RaphMTHN/Drone-Arduino/README.md

# Drone-Arduino

A personnal project about making a drone from scratch

## Description

*TODO*

## References

Don't forget to check Jeff Rowberg's awesome job on the MPU5060 I'm using in this project !
