RaphMTHN/Drone-Arduino/3 Implementation et Ajustement du Modele/1 Implementation du Systeme/3 Core/Drone_Core/README.md

# Arduino Drone Core

## Utilisation

Le code a été développé et testé sur une carte Arduino Uno.

Il est nécessaire de copier les fichiers .h et .cpp requis dans le même répertoire que le fichier .ino afin que le code puisse compiler.
