RaphMTHN/Drone-Arduino/Vidéos/liens_youtube.md

# Liens Vidéos Youtube

[Projet Drone Arduino - Maquette instable](https://www.youtube.com/watch?v=5RiZT9Iv7X4)

[Projet Drone Arduino - Maquette stable (perturbation)](https://www.youtube.com/watch?v=U1GrYymJwgQ)

[Projet Drone Arduino - Maquette stable (échelon)](https://www.youtube.com/watch?v=97mEfpeCfaE)
