RaphMTHN/Drone-Arduino/Rapport/Equations/Coefficients.docx

## Hélice

ρ=1,255 kg m^(-3)

D_(constr) =0,2375 m

e_(constr) =0,02 m

Cp_(ideal) =0,76

C_(pexp) =0,66

K_(h_(const)) =9,26 E^(-6) N(rad s^(-1) )^(-2)

D_(maquette) =0,15 m

e_(maquette) =0,02m

K_(h_(maquette)) =1,75 E^(-6) N(rad s^(-1) )^(-2)

## Moteur

K_m =954 rad s^(-1)

C_0 =40%

τ=0,01 s

## Linéarisation Hélice

K_(hlin) =1,34E^(-3) N(rad s^(-1) )^(-1)

R_(i0) =0,255 N

## Inertie

λ=0,194 kg m^(-1)

L=0,24 m

l= 0,22 m

m_(moteur) =0.080 kg

J= 9,53 E^(-3) kg m^2

## Modèle de connaissance

K=11,27

τ=0,01 s

## Adaptation du modèle

K^(*) =31.4

τ^(*) =0,0137

K_(ajust) =2,79

K_(u0) =0,514

K_(consigne) =0,191
