RaphMTHN/Drone-Arduino/2 Modele de Connaissance/1 Helice/Graphiques/Courbe b'.pdf

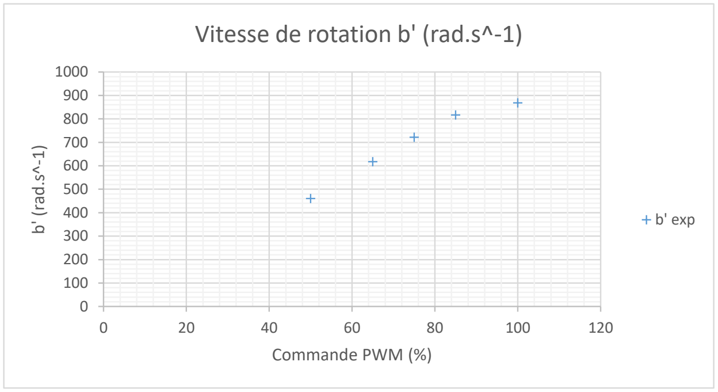
[picture p16: figure]
b' (rad.s^-1); Commande PWM (%); Vitesse de rotation b' (rad.s^-1); b' exp
