RaphMTHN/Drone-Arduino/5 Conclusion/conclusion.md

# Conclusion

## Analyse des résultats 

L’identification des paramètres du moteur et des hélices a permis de confirmer la validité des lois théoriques qui constituent le premier modèle.

L’ajustement de la modélisation corrige les imperfections causées par des hypothèses simplificatrices. Cependant, l’écart est assez important. Le modèle de connaissance n'est pas assez précis pour décrire le comportement réel du système.

Il faudra revoir la détermination des paramètres des différentes relations associées aux composants si l'on souhaite diminuer l'écart entre modèle de connaissance et modèle expérimental.

Le modèle ajusté a un comportement optimal pour des faibles corrections dérivatrices initiales.

Les réponses temporelles en suivi et en régulation de la maquette et de la modélisation se superposent très correctement.

Le système modélisé est plus rapide que le système réel. La maquette, cependant, présente des dépassements moins importants en réponse indicielle que la modélisation.

## Conclusion générale

Une fois les étapes d’analyse et d’élaboration d’un modèle théorique réalisées, c’est par la réalisation concrète et complète d’une maquette, et par l’ajustement de la modélisation au comportement du système réel que je suis parvenu à valider une première loi de commande, capable de s’adapter à des perturbations imprévisibles. S’il est impossible d’affirmer que la correction du système est optimale, la recherche de l’optimalité a été un fil conducteur au cours de mon travail.
