RaphMTHN/Drone-Arduino/Rapport/Equations/equation de dynamique.docx

J=2 ( (λL^3)/3+m_(moteur) l^2 )

λ :masse volumique du bras

L :longueur du bras

l :distance du moteur à l'axe

m_(moteur) :masse de l^(') ensemble moteur+hélice+variateur

On fait l’hypothèse que le système est parfaitement équilibré : le couple exercé par la pesanteur s’annule par symétrie.

On applique le théorème de la résultante dynamique au système en O projeté sur l’axe de roulis :

Jα=(R_3 -R_2 )l^2

α :angle de roulis
