RaphMTHN/Drone-Arduino/Rapport/Equations/fonction de transfert du système.docx

H_(BO) (p)=K/(p^2 (1+τp))

K=(2K_(consigne) K_m K_(h_(lin)) l^2)/J=26,14

τ=0,1 s

Le système est intrinsèquement instable : il faut nécessairement ajouter un correcteur dérivateur pour avoir une phase inférieure à π/2 . Ainsi, une fois un tel correcteur ajouté :

H_(BF) (p)=(K(K_p +K_d p))/(KK_p +KK_d p+p^2 +τp^3)

Le critère de Routh appliqué à la fonction de transfert du système corrigé par un dérivateur, de coefficient fixé K_d est :

K_p >0

K_p <(K_d)/τ

Le point critique est atteint lorsque le dénominateur de la fonction de transfert s’annule : l’étude fréquentielle du dénominateur fournit une équation respectée par la pulsation du système :

((KK_d)/τ-ω_u^2 )+jω_u τ((KK_d)/τ-ω_u^2 )=0

Ainsi les coordonnées du point critique sont, pour une valeur du gain du correcteur dérivateur K_d fixé :

K_u =K_d /τ

T_u =2π√(τ/(KK_d))

K_u =(K_d)/τ+K_(u0)
