RaphMTHN/Drone-Arduino/Rapport/Equations/traction de l'hélice.docx

En intégrant dFp_i sur toute l’hélice, d’incidence constante et symétrique par rapport à son axe de rotation, on obtient l’expression suivante :

La force de portance s’exerçant sur chaque petit élément de pale s’exprime :

dFp_i =1/2ρC_p Sv^2 z_i

Où :

ρ=1,255 kg m^(-3) :masse volumique de l'air

C_p :coefficient de portance de l'hélice

S=e dr :surface de l^(') élément de pale

e :épaisseur de l'hélice

β_i :vitesse de rotation de l'hélice

v=rβ_i :vitesse apparent de l'air

Ainsi :

R_i =Fp_i =1/24ρC_p eD^3 β_i ^2 z_i

Où :

D :diamètre de l'hélice
