RaphMTHN/Drone-Arduino/Rapport/Image Légende/image legende.docx

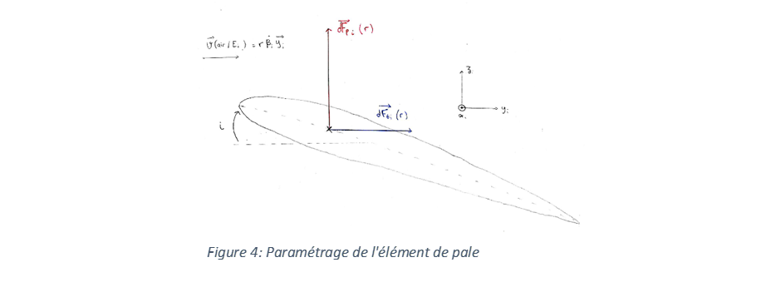
[picture p37: figure]
