RaphMTHN/Drone-Arduino/Rapport/Modalites Actions/Hélice.docx

# Hélice

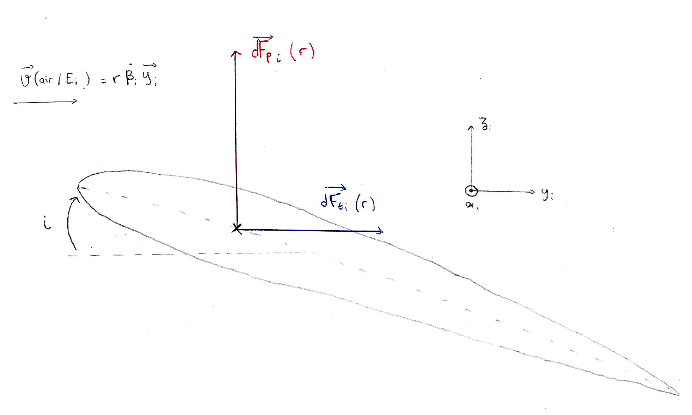
[picture p45: figure]

La force de portance s’exerçant sur chaque petit élément de pale s’exprime :

dFp_i =1/2ρC_p Sv^2 z_i

Où :

ρ=1,255 kg m^(-3) :masse volumique de l'air

C_p :coefficient de portance de l'hélice

S=e dr :surface de l^(') élément de pale

e :épaisseur de l'hélice

β_i :vitesse de rotation de l'hélice

v=rβ_i :vitesse apparent de l'air

Ainsi :

R_i =Fp_i =K_h β_i ^2 z_i

K_h =1/24ρC_p eD^3

Où :

D :diamètre de l'hélice

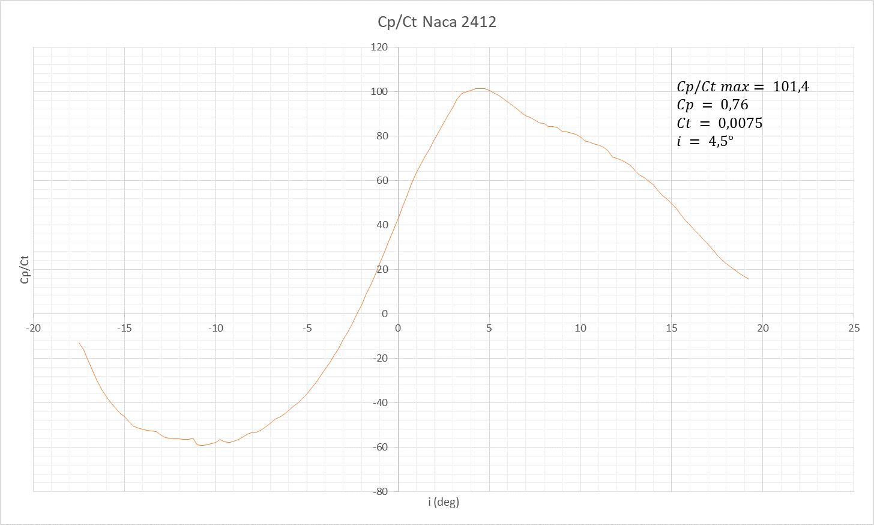
[picture p46: figure]
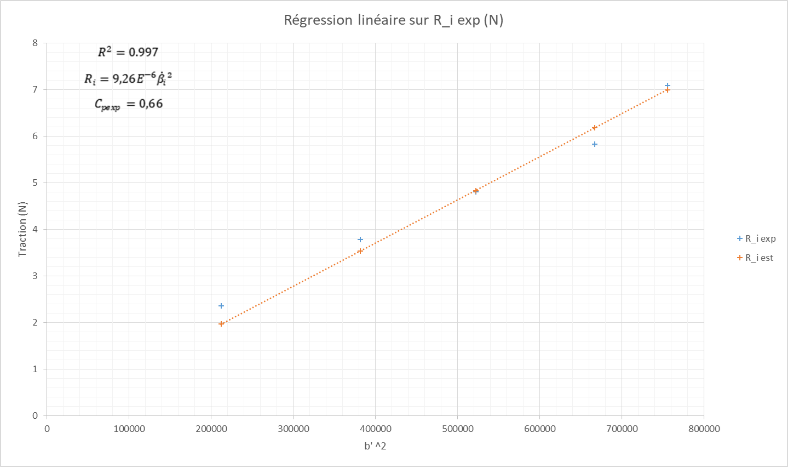
[picture p47: figure]

On identifie ainsi:

K_(h_(const)) =9,26 E^(-6) N(rad s^(-1) )^(-2)

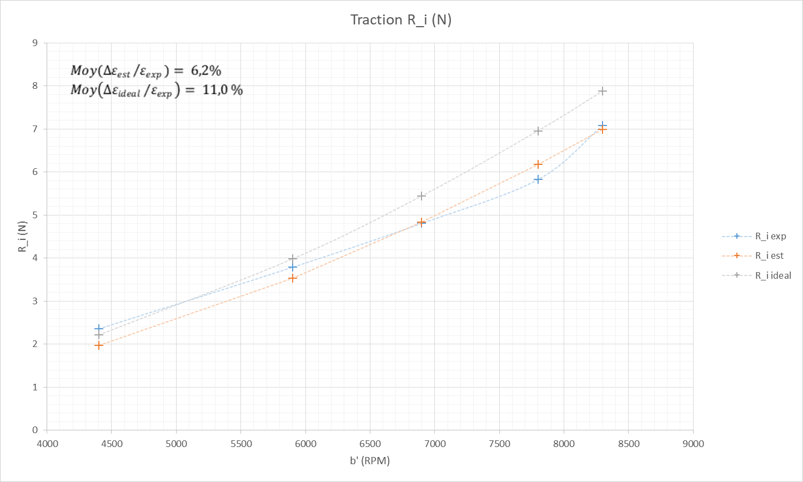
[picture p48: figure]

On adapte la valeur de K_(hmaquette) à l’aide des données géométriques des hélices installées sur la maquette, différentes de celles proposées par le constructeur :

D_(constr) =0,2375 m

e_(constr) =0,02 m

D_(maquette) =0,15 m

e_(maquette) =0,02m

D’où :

K_(h_(maquette)) =1,75 E^(-6) N(rad s^(-1) )^(-2)

On linéarise l’expression de la traction autour du point de fonctionnement de vol stationnaire :

R_i =K_(hlin) β_i +R_(i0)

K_(hlin) =2K_h β_(i0)

R_(i0) =K_h β_(i0)^2

On trouve, en choisissant le point de fonctionnement à 40% de la consigne maximale des moteurs :

C_0 =40%

K_(hlin) =1,34E^(-3) N(rad s^(-1) )^(-1)

R_(i0) =0,255 N

# Analyse des résultats

L’expression de la traction est confortée par le faible écart entre les résultats fournis par le constructeur du moteur et la régression linéaire. L’ordre de grandeur du coefficient de poussée adimensionné Cp est proche du Cp idéal pour un profil NACA (10% plus efficace en théorie).
