RaphMTHN/Drone-Arduino/2 Modele de Connaissance/2 Moteur/Reg Lin b' edited.docx

R²=0,9998

β=954 C_i

K_m =954 rad s^(-1)

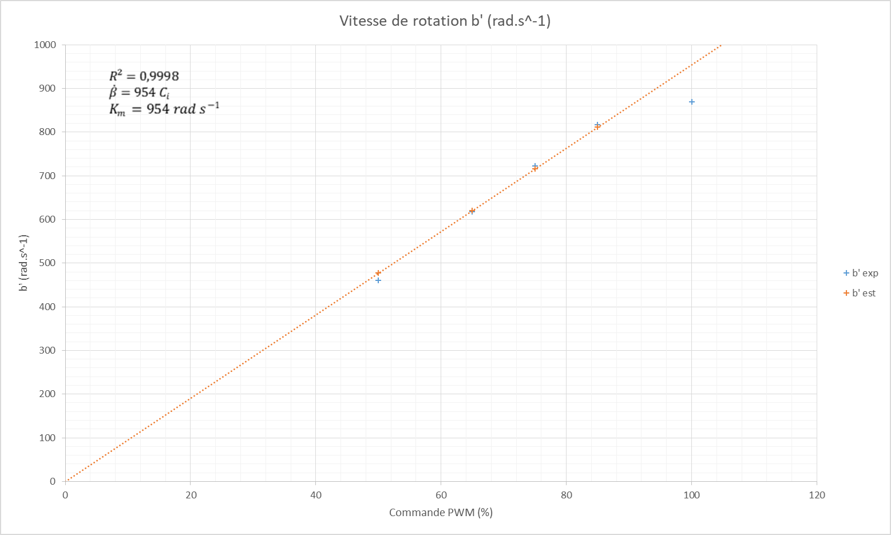
[picture p52: figure]
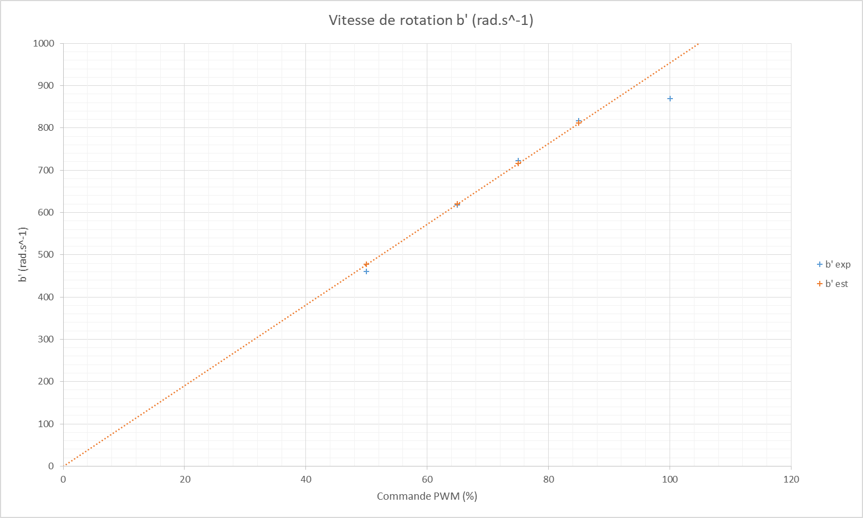
[picture p53: figure]
