RaphMTHN/Drone-Arduino/2 Modele de Connaissance/1 Helice/Graphiques retenus/1 Cp Naca 2412.docx

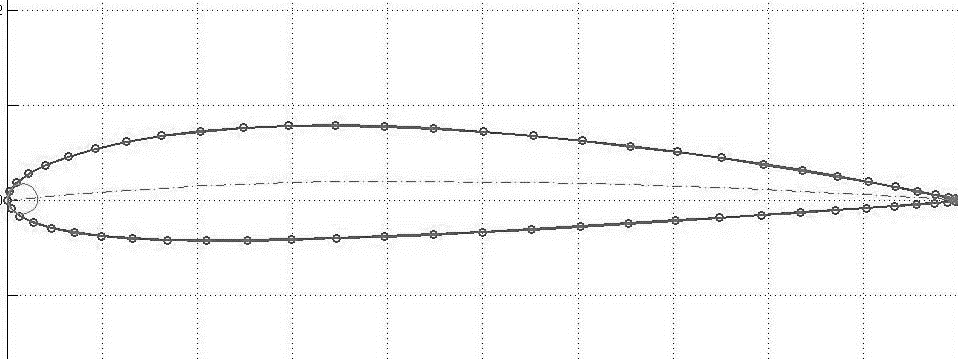
[picture p54: figure]
Résultat de recherche d'images pour "naca2412"
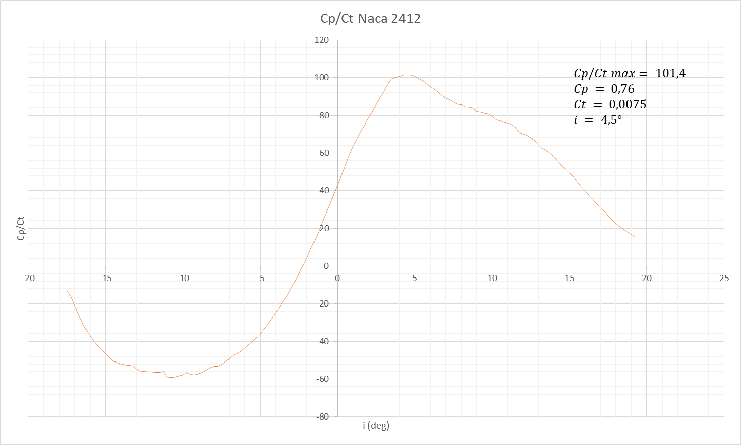
[picture p55: figure]
