RaphMTHN/Drone-Arduino/2 Modele de Connaissance/1 Helice/Graphiques retenus/2 Reg Lin R_i edited 2.docx

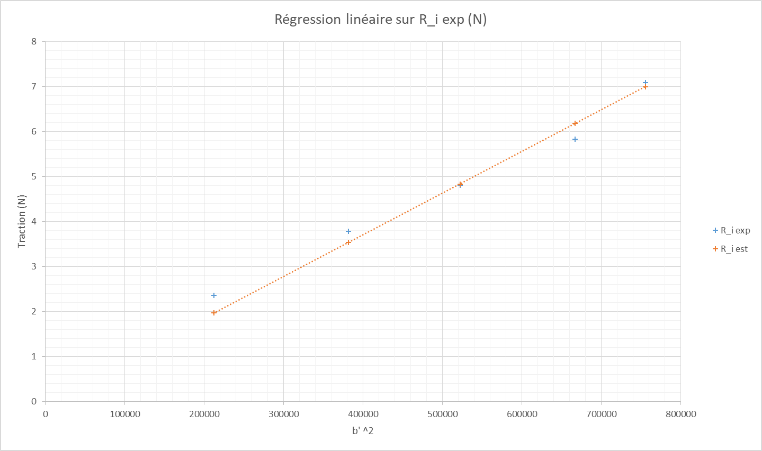
[picture p56: figure]
