RaphMTHN/Drone-Arduino/2 Modele de Connaissance/1 Helice/Graphiques retenus/2 Reg Lin R_i edited.docx

R^2 =0.997

R_i =9,26E^(-6) β_i ²

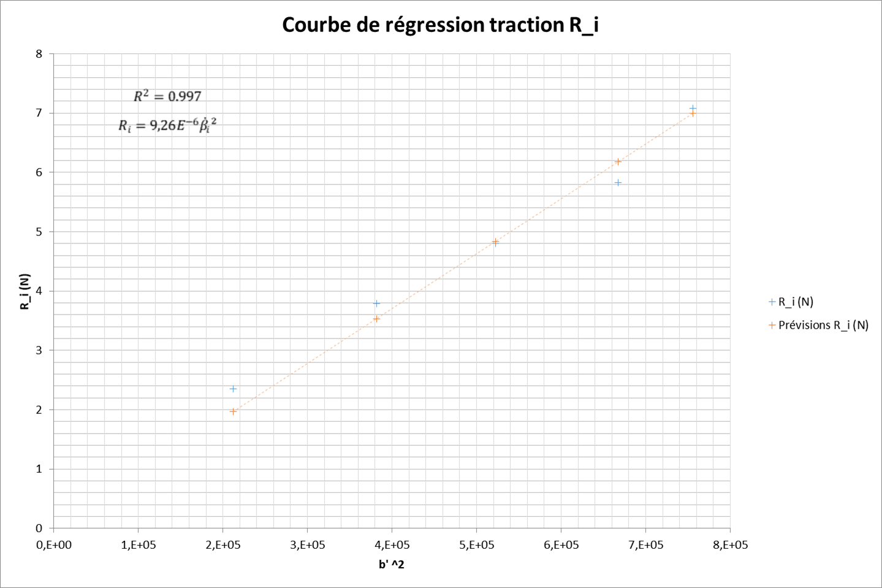
[picture p57: figure]
