RaphMTHN/Drone-Arduino/2 Modele de Connaissance/1 Helice/Graphiques retenus/3 Synthese modeles.docx

Moy((∆ε_(est))/(ε_(exp)))= 6,2%

Moy((∆ε_(ideal))/(ε_(exp)))= 11,0 %
