RaphMTHN/Drone-Arduino/2 Modele de Connaissance/1 Helice/Graphiques retenus/4 Linearisation Traction.docx

(∆ε_(lin))/(ε_(mod) <20% C_i ∈[28% ;72%])

C_(i0) = 40 %

K_(hlin) =7,07 E^(-3) N.(rad.s^(-1) )^(-1)

R_(i0) =1,348 N

K_(hlin) =2K_h β_0

R_(i0) =K_h β_0 ²
