RaphMTHN/Drone-Arduino/3 Implementation et Ajustement du Modele/2 Ajustement du Modele/Regressions Lineaires/Regression Ku adap.docx

R^2 =0,994

T_(uexp) =7,32*Kd+0,514

R^2 =0,994

T_(uexp) =7,32*Kd+0,514

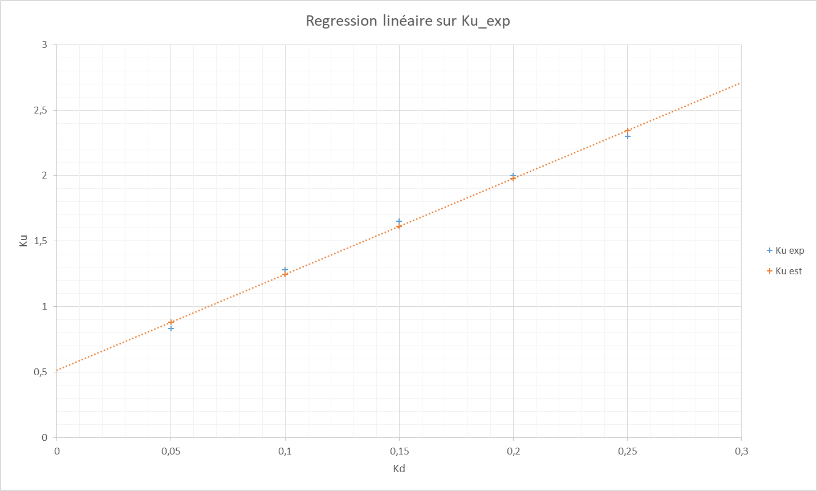
[picture p58: figure]
