RaphMTHN/Drone-Arduino/3 Implementation et Ajustement du Modele/2 Ajustement du Modele/Regressions Lineaires/Regression Tu adap.docx

R^2 =0,999

T_(uexp) =0,415√(1/(Kd))

R^2 =0,999

T_(uexp) =0,415√(1/(Kd))

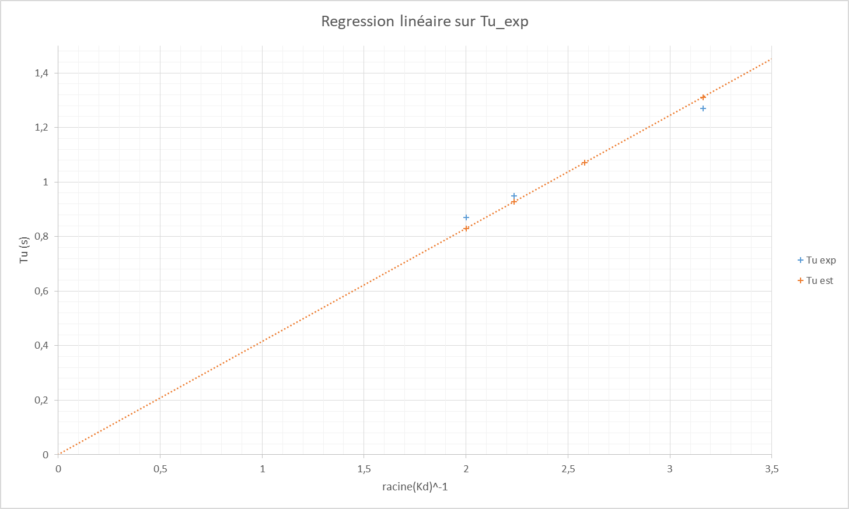
[picture p59: figure]
