RaphMTHN/Drone-Arduino/2 Modele de Connaissance/3 Dynamique/Inertie/pseudo_dessin_indus_maquette.pdf

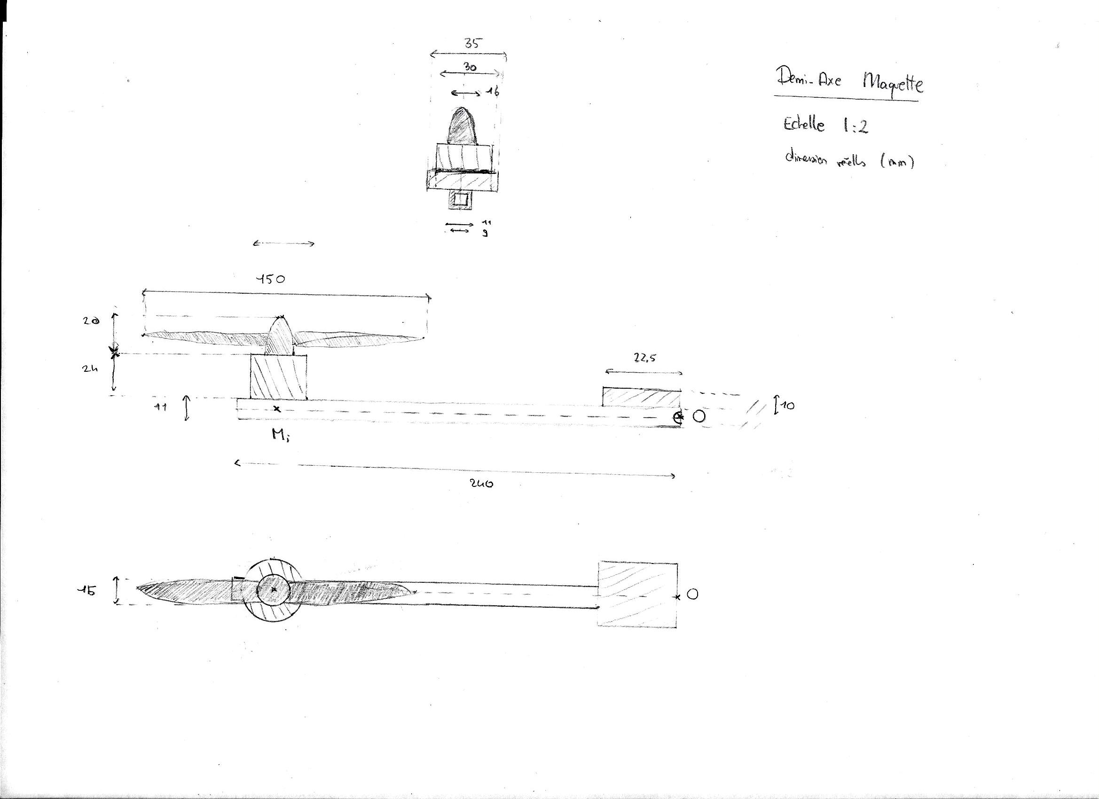
[picture p69: page 1]
