RaphMTHN/Drone-Arduino/2 Modele de Connaissance/1 Helice/Graphiques/Reg Lin b'.pdf

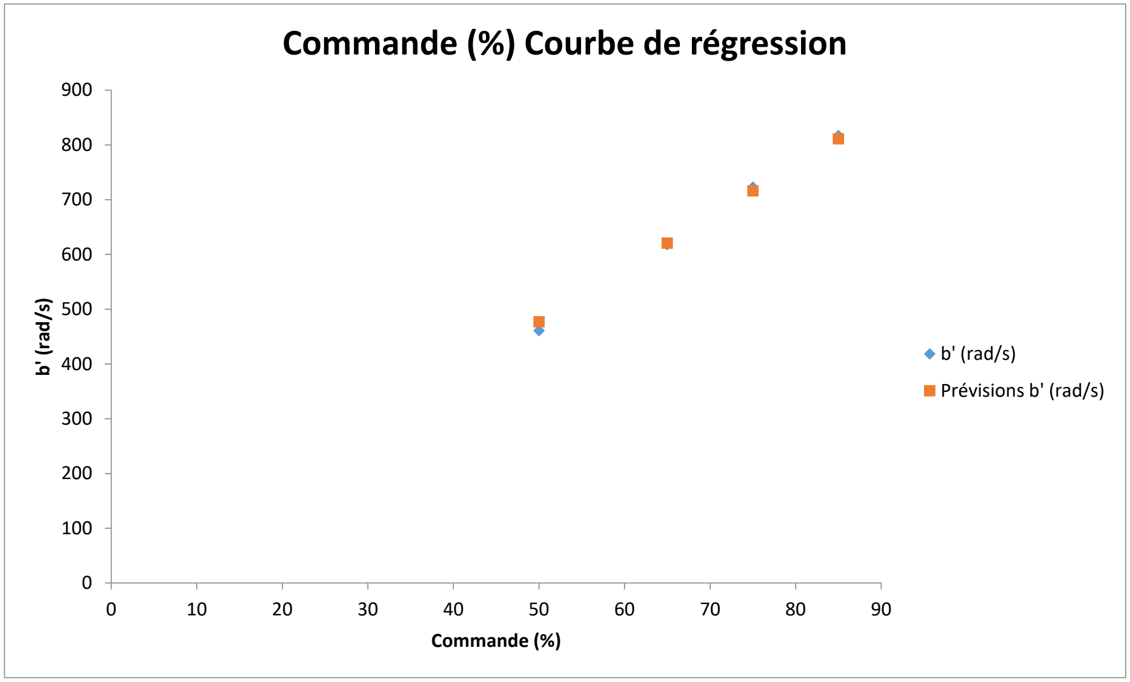
[picture p70: figure]
b' (rad/s); Commande (%); Commande (%) Courbe de régression; Prévisions b' (rad/s)
