RaphMTHN/Drone-Arduino/2 Modele de Connaissance/1 Helice/Graphiques/Reg Lin P_i.pdf

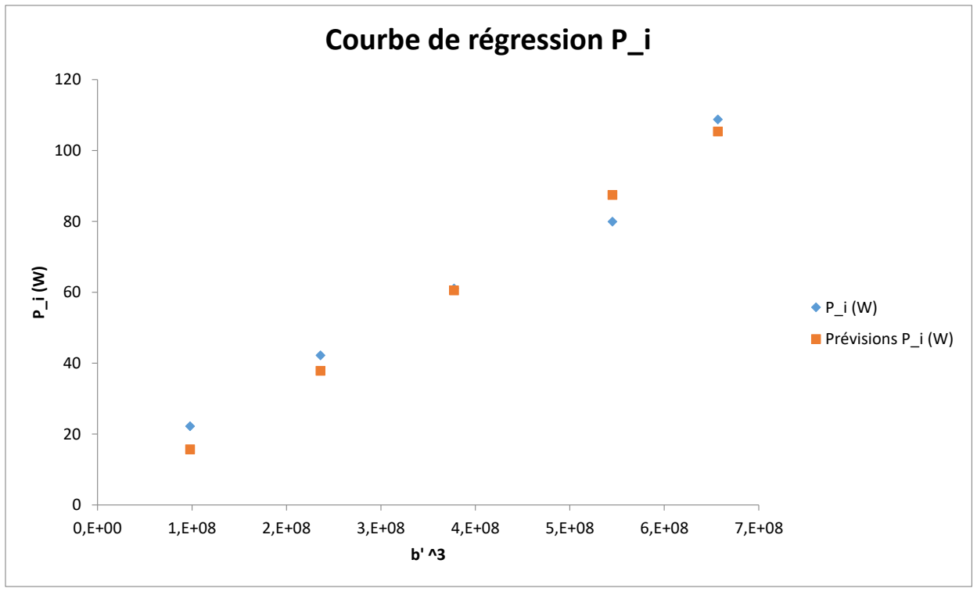
[picture p71: figure]
Courbe de régression P_i; Prévisions P_i (W)
