RaphMTHN/Drone-Arduino/2 Modele de Connaissance/1 Helice/Graphiques/Reg Lin R_i.pdf

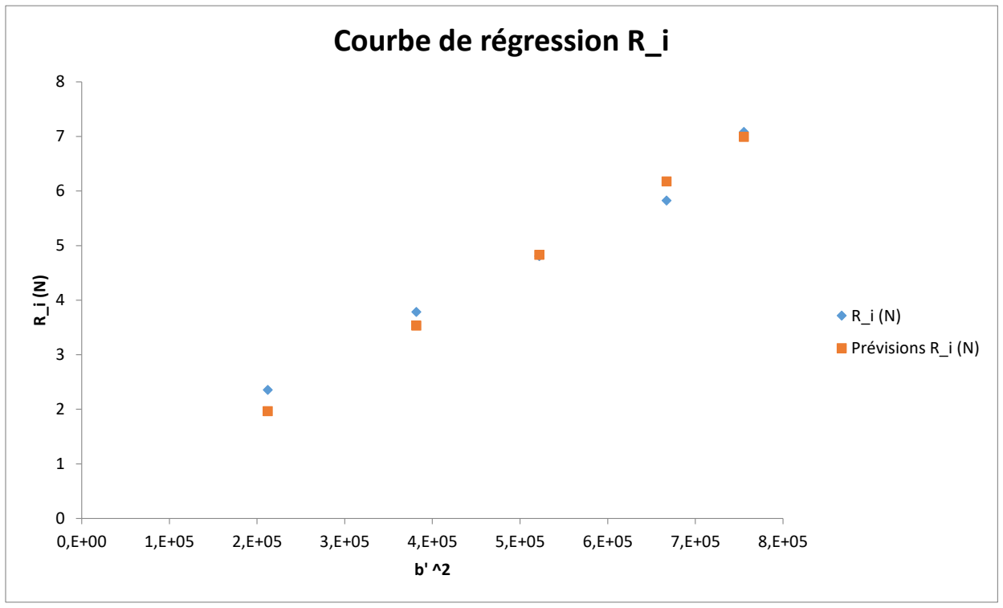
[picture p72: figure]
Courbe de régression R_i; Prévisions R_i (N)
