RaphMTHN/Drone-Arduino/2 Modele de Connaissance/1 Helice/Graphiques/Synthese P_i.pdf

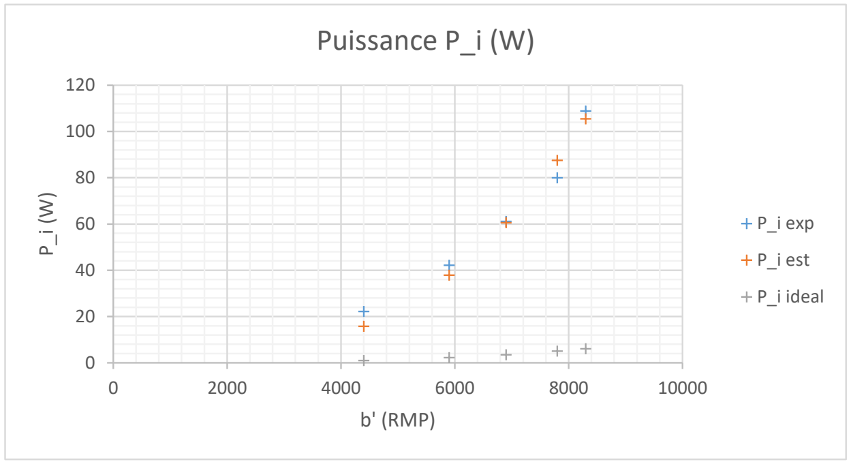
[picture p73: figure]
b' (RMP); Puissance P_i (W); P_i exp; P_i est; P_i ideal
