RaphMTHN/Drone-Arduino/2 Modele de Connaissance/1 Helice/Graphiques/Synthese R_i.pdf

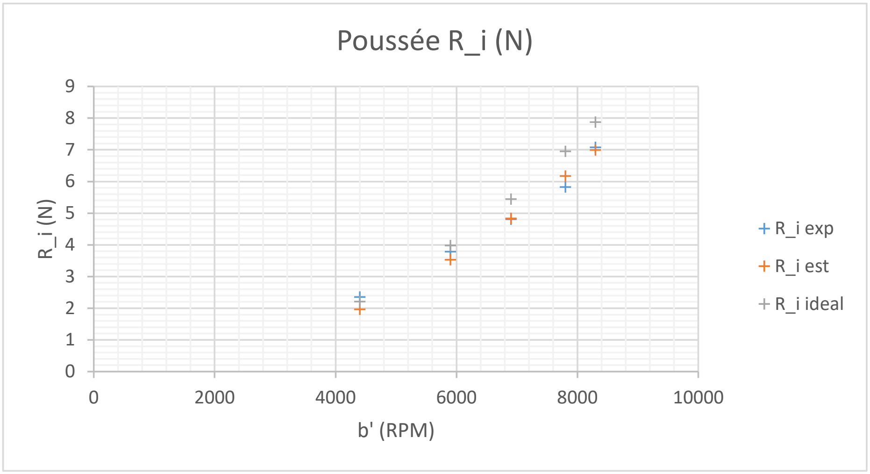
[picture p74: figure]
b' (RPM); Poussée R_i (N); R_i exp; R_i est; R_i ideal
