RaphMTHN/Drone-Arduino/2 Modele de Connaissance/1 Helice/Profil Naca 2412/Graphiques/Profil Naca 2412 cp graph.pdf

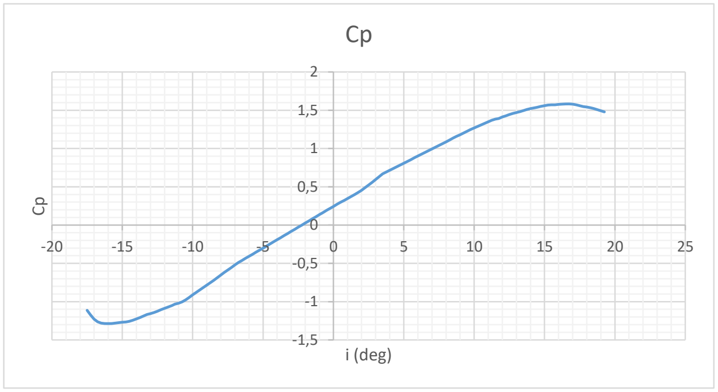
[picture p75: figure]
i (deg)
