RaphMTHN/Drone-Arduino/2 Modele de Connaissance/1 Helice/Profil Naca 2412/Graphiques/Profil Naca 2412 cp-ct graph.pdf

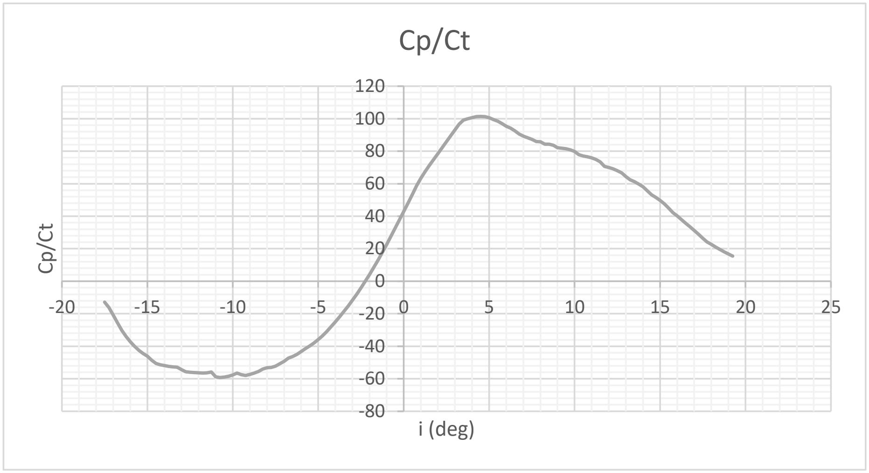
[picture p76: figure]
i (deg)
