RaphMTHN/Drone-Arduino/2 Modele de Connaissance/1 Helice/Profil Naca 2412/Graphiques/Profil Naca 2412 ct graph.pdf

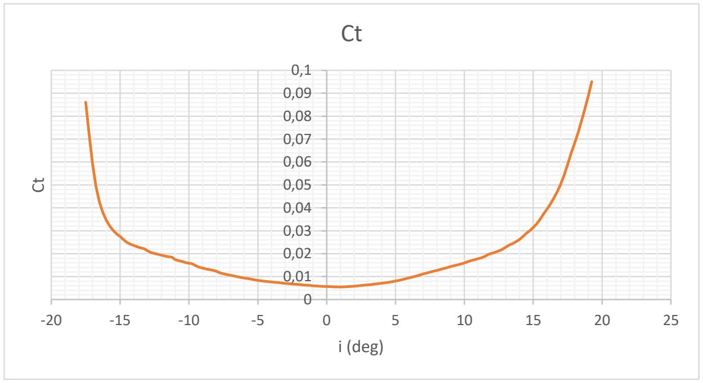
[picture p77: figure]
i (deg)
