RaphMTHN/Drone-Arduino/2 Modele de Connaissance/1 Helice/Profil Naca 2412/Graphiques/Profil Naca 2412 polaire graph.pdf

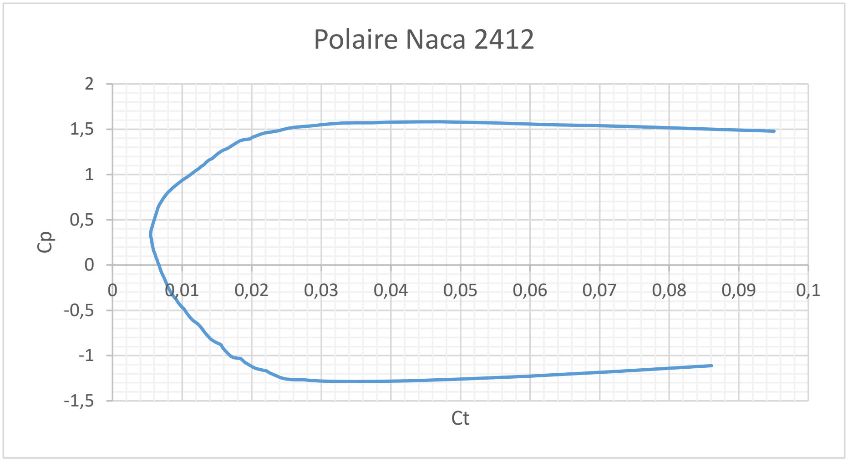
[picture p78: figure]
Polaire Naca 2412
