RaphMTHN/Drone-Arduino/0 Introduction/cycle_de_developpement_v.png

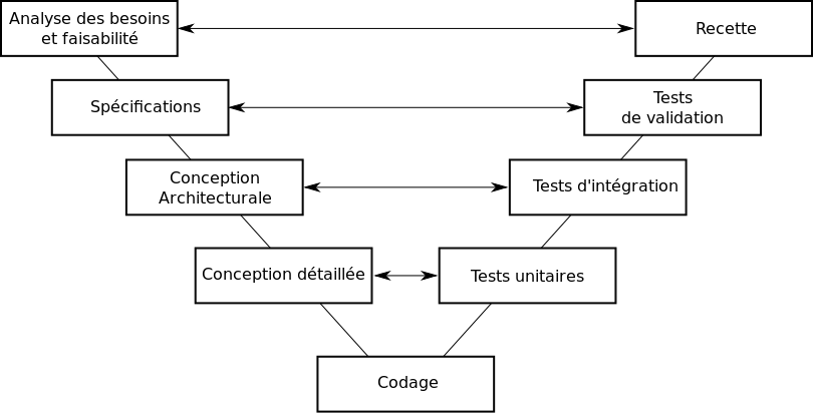
0 Introduction/cycle_de_developpement_v.png
