RaphMTHN/Drone-Arduino/1 Analyse Fonctionnelle/1 Cas d'Utilisation/Fpv drone.jpg

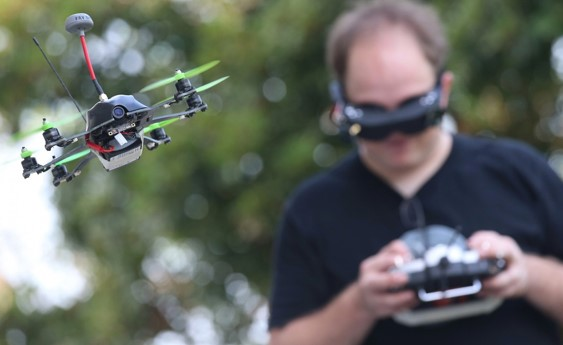
1 Analyse Fonctionnelle/1 Cas d'Utilisation/Fpv drone.jpg
