RaphMTHN/Drone-Arduino/1 Analyse Fonctionnelle/1 Cas d'Utilisation/Novadem drone RTE.jpg

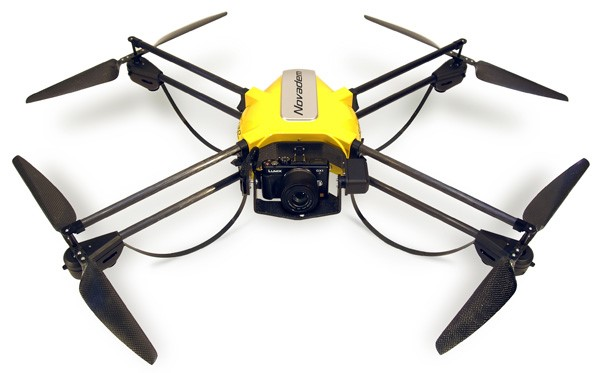
1 Analyse Fonctionnelle/1 Cas d'Utilisation/Novadem drone RTE.jpg
