RaphMTHN/Drone-Arduino/1 Analyse Fonctionnelle/1 Cas d'Utilisation/RTE drone 1.jpg

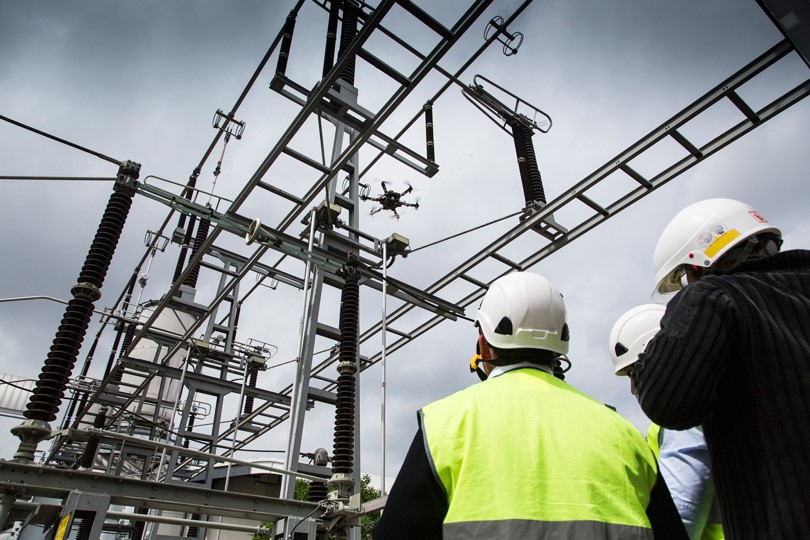
1 Analyse Fonctionnelle/1 Cas d'Utilisation/RTE drone 1.jpg
