RaphMTHN/Drone-Arduino/1 Analyse Fonctionnelle/1 Cas d'Utilisation/RTE drone 2.jpg

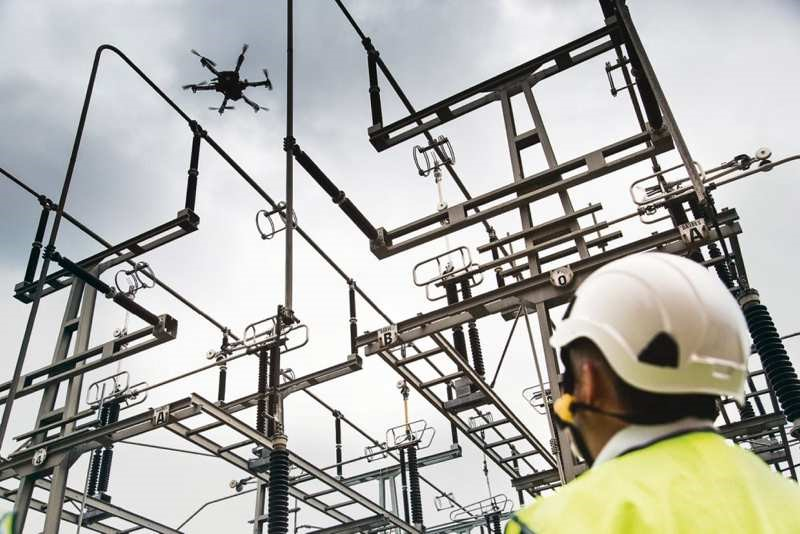
1 Analyse Fonctionnelle/1 Cas d'Utilisation/RTE drone 2.jpg
