RaphMTHN/Drone-Arduino/1 Analyse Fonctionnelle/2 Chaine Energie Info/Diagramme chaîne information - energie.png

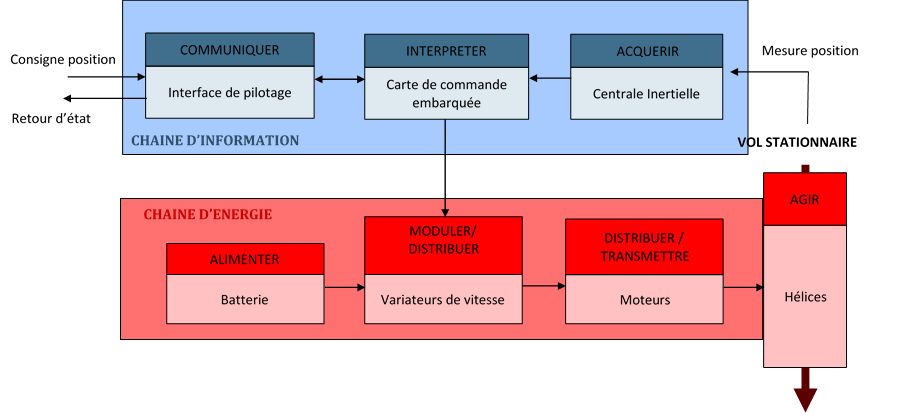
1 Analyse Fonctionnelle/2 Chaine Energie Info/Diagramme chaîne information - energie.png
