RaphMTHN/Drone-Arduino/1 Analyse Fonctionnelle/3 Schema Bloc Fonctionnel/schema_bloc_fonctionnel.png

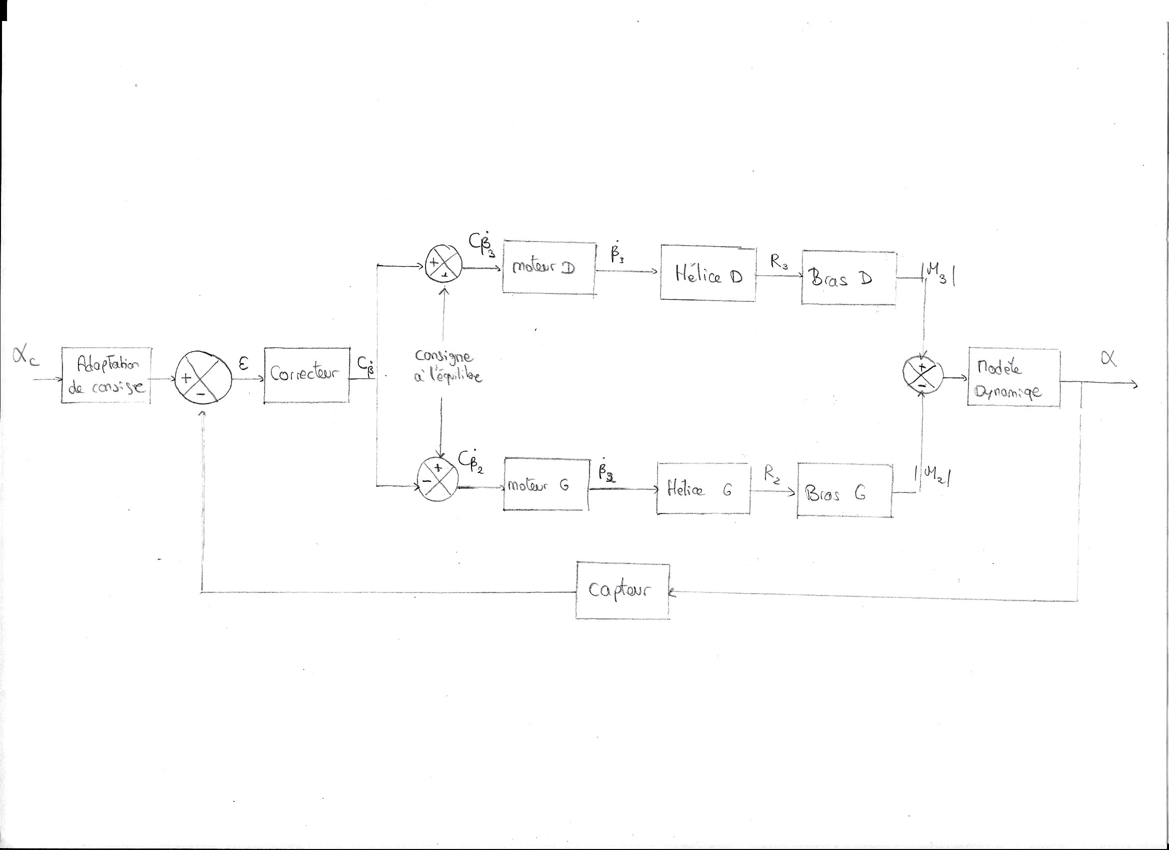
1 Analyse Fonctionnelle/3 Schema Bloc Fonctionnel/schema_bloc_fonctionnel.png
