RaphMTHN/Drone-Arduino/2 Modele de Connaissance/1 Helice/Calcul Reynolds.jpg

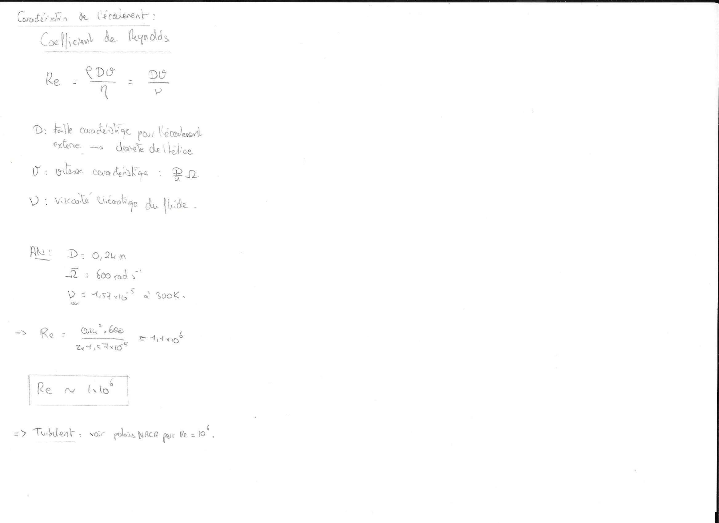
2 Modele de Connaissance/1 Helice/Calcul Reynolds.jpg
