RaphMTHN/Drone-Arduino/2 Modele de Connaissance/1 Helice/Graphiques retenus/Linearisation traction.png

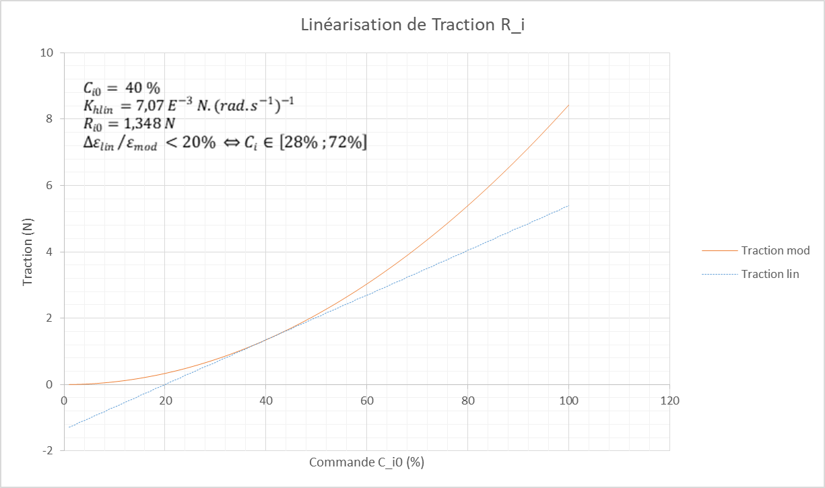
2 Modele de Connaissance/1 Helice/Graphiques retenus/Linearisation traction.png
