RaphMTHN/Drone-Arduino/2 Modele de Connaissance/1 Helice/linearisation_helice.jpg

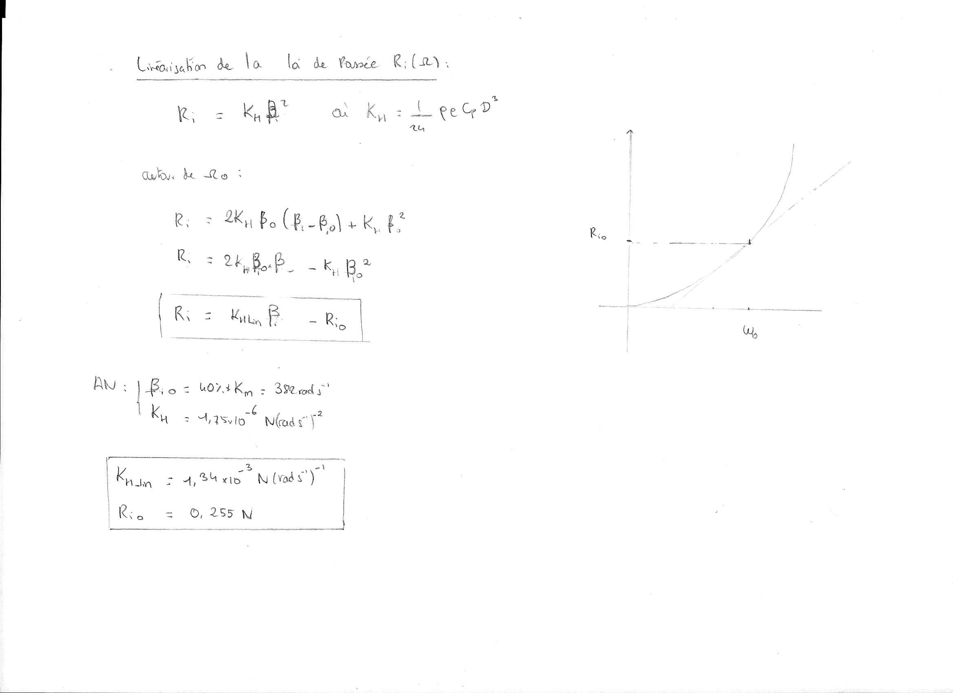
2 Modele de Connaissance/1 Helice/linearisation_helice.jpg
