RaphMTHN/Drone-Arduino/2 Modele de Connaissance/1 Helice/Profil Naca 2412/profil naca 2412 parametre.png

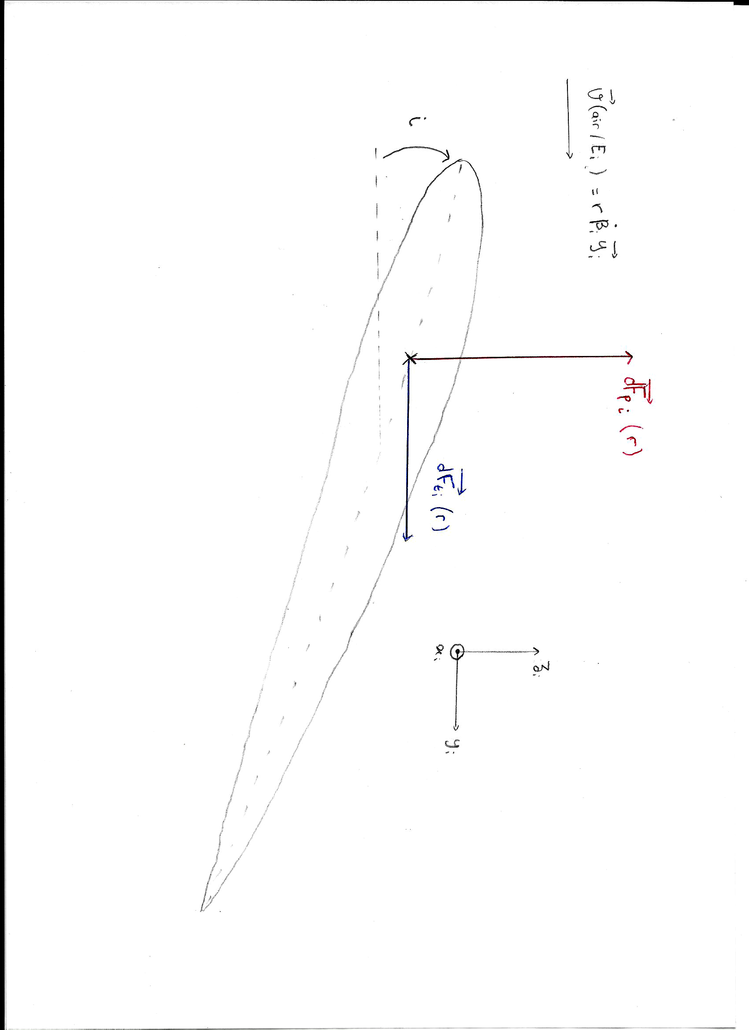
2 Modele de Connaissance/1 Helice/Profil Naca 2412/profil naca 2412 parametre.png
