RaphMTHN/Drone-Arduino/2 Modele de Connaissance/3 Dynamique/Inertie/calcul_inertie.jpg

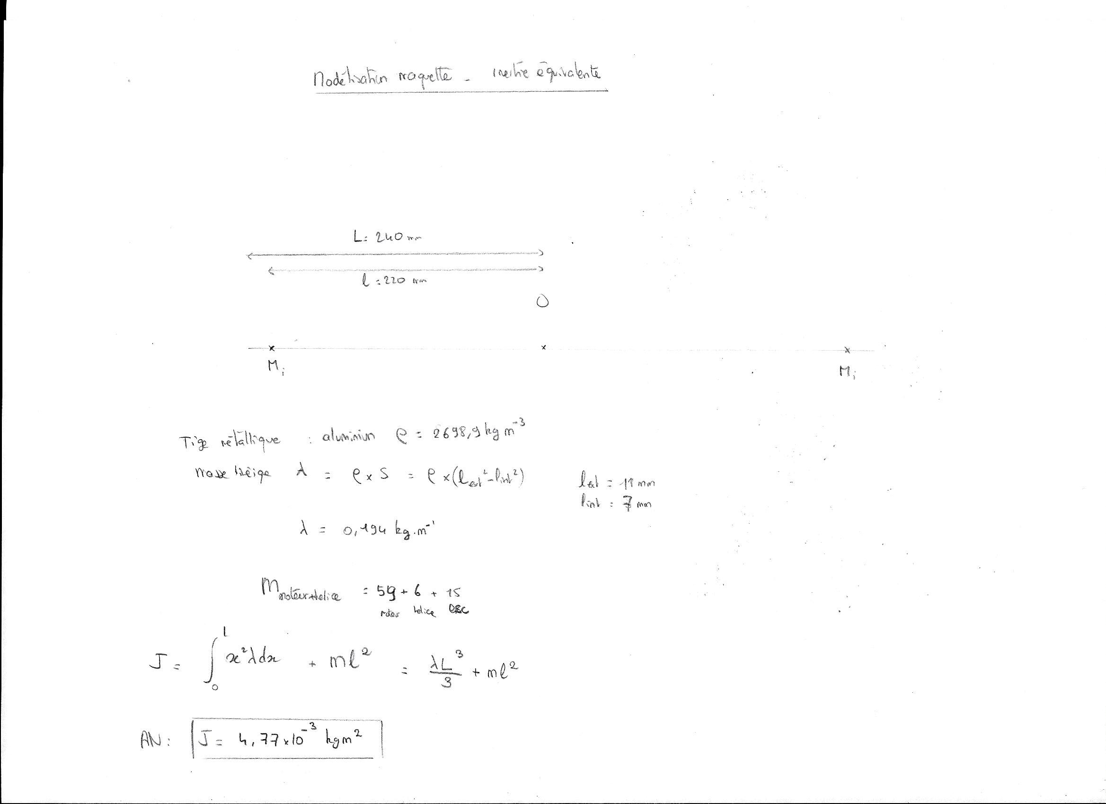
2 Modele de Connaissance/3 Dynamique/Inertie/calcul_inertie.jpg
