RaphMTHN/Drone-Arduino/2 Modele de Connaissance/5 Modelisation Complete/modelisation_causale_maquette.png

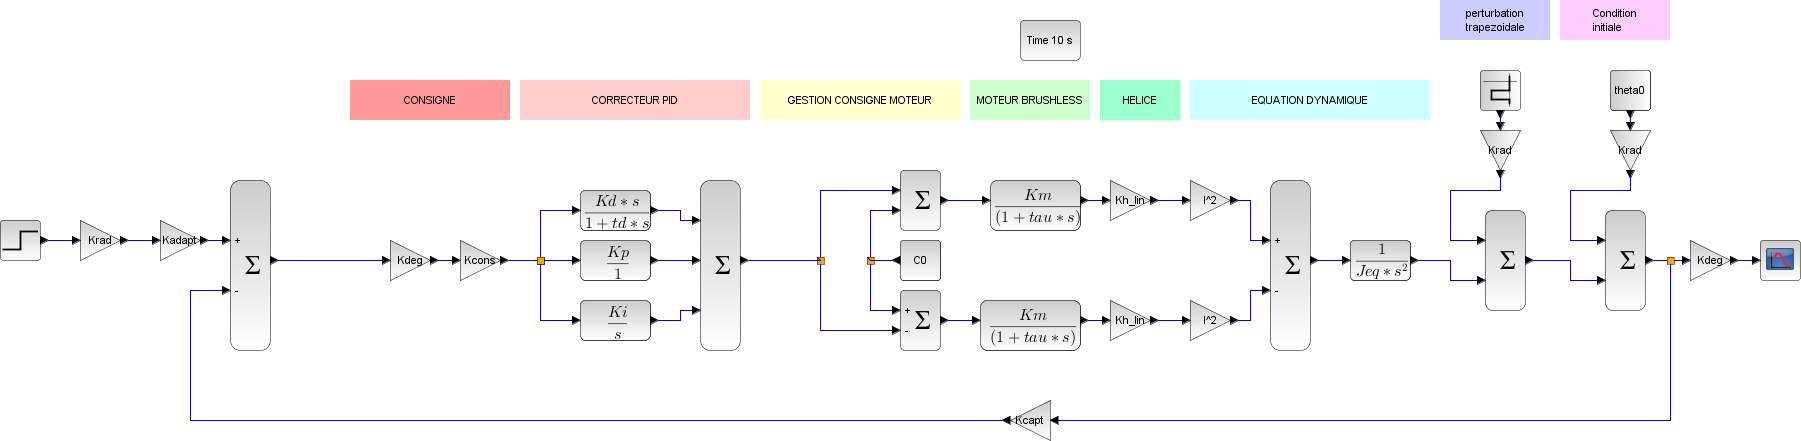
2 Modele de Connaissance/5 Modelisation Complete/modelisation_causale_maquette.png
