RaphMTHN/Drone-Arduino/2 Modele de Connaissance/5 Modelisation Complete/respect_routh_simu.png

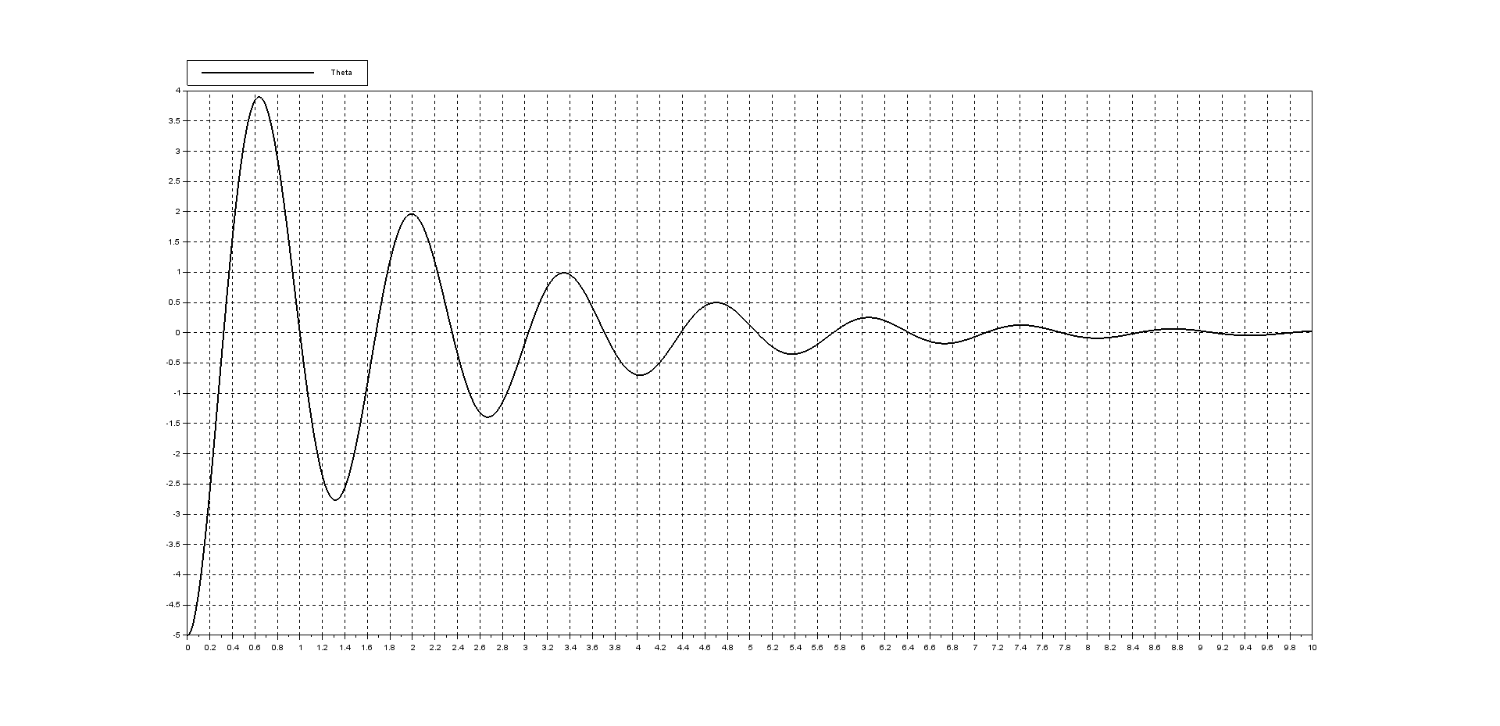
2 Modele de Connaissance/5 Modelisation Complete/respect_routh_simu.png
