RaphMTHN/Drone-Arduino/2 Modele de Connaissance/5 Modelisation Complete/Routh_simulation_Kd_0.1.png

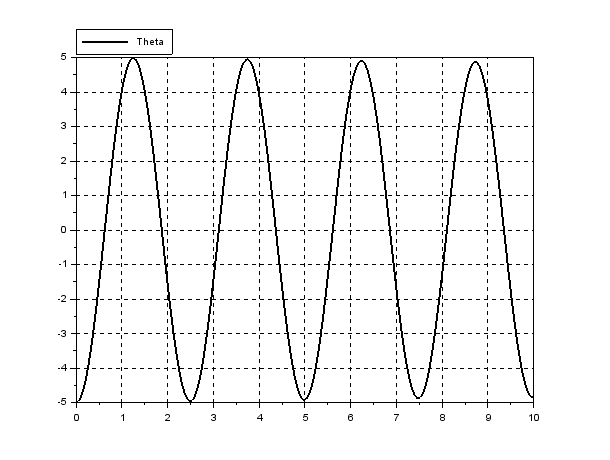
2 Modele de Connaissance/5 Modelisation Complete/Routh_simulation_Kd_0.1.png
