RaphMTHN/Drone-Arduino/3 Implementation et Ajustement du Modele/2 Ajustement du Modele/Critere Routh/critere_routh_1.jpg

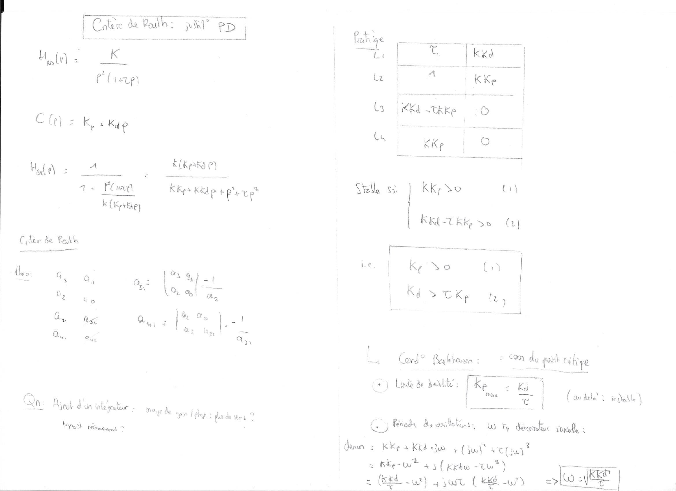
3 Implementation et Ajustement du Modele/2 Ajustement du Modele/Critere Routh/critere_routh_1.jpg
