RaphMTHN/Drone-Arduino/3 Implementation et Ajustement du Modele/2 Ajustement du Modele/Regressions Lineaires/reg_lin_Tu.png

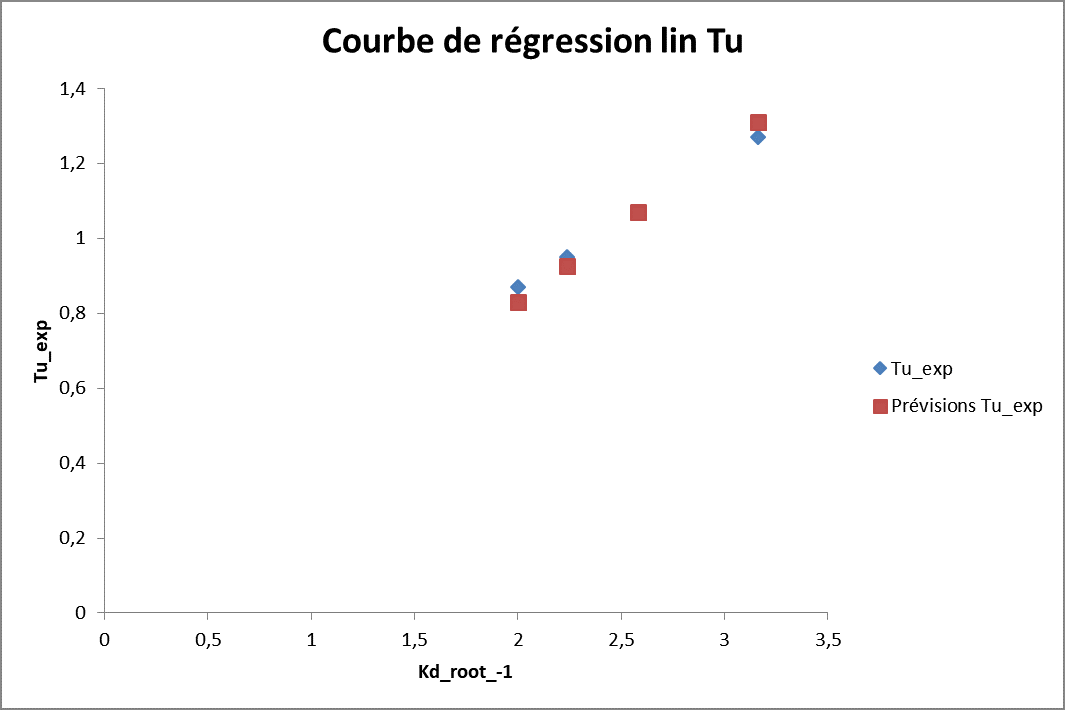
3 Implementation et Ajustement du Modele/2 Ajustement du Modele/Regressions Lineaires/reg_lin_Tu.png
