RaphMTHN/Drone-Arduino/2 Modele de Connaissance/1 Helice/Donnees Constructeur/tmotor_air_2213_data.jpg

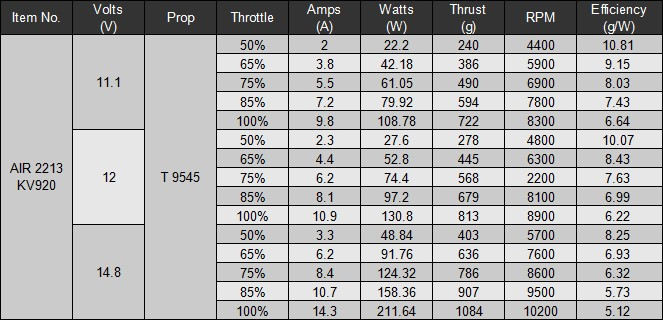
2 Modele de Connaissance/1 Helice/Donnees Constructeur/tmotor_air_2213_data.jpg
