RaphMTHN/Drone-Arduino/4 Evaluation des Performances/1 Correction Modele/calcul parametre zn.xlsx

Kd_initial | Ku | Tu | Kp | Ki | Kd | Paramètres
0.10 | 1.28 | 1.27 | 0.77 | 1.21 | 0.22 | K | 19.08
0.15 | 1.92 | 1.04 | 1.15 | 2.22 | 0.30 | tau | 0.078
0.20 | 2.56 | 0.90 | 1.54 | 3.43 | 0.37
0.25 | 3.21 | 0.80 | 1.92 | 4.79 | 0.44
0.30 | 3.85 | 0.73 | 2.31 | 6.29 | 0.51
0.40 | 5.13 | 0.64 | 3.08 | 9.69 | 0.64
0.50 | 6.41 | 0.57 | 3.85 | 13.54 | 0.77
1.00 | 12.82 | 0.40 | 7.69 | 38.30 | 1.39
2.00 | 25.64 | 0.28 | 15.38 | 108.32 | 2.55
