RaphMTHN/Drone-Arduino/4 Evaluation des Performances/3 Correction maquette/calcul parametre zn 2.xlsx

Kd_initial | Ku | Tu | Kp | Ki | Kd | Paramètres
0.10 | 1.24 | 1.68 | 0.75 | 0.89 | 0.26 | K | 19.08
0.15 | 1.61 | 1.37 | 0.97 | 1.40 | 0.32 | tau | 0.137
0.20 | 1.97 | 1.19 | 1.18 | 1.99 | 0.38 | Ku0 | 0.514
0.25 | 2.34 | 1.06 | 1.40 | 2.64 | 0.44
0.30 | 2.70 | 0.97 | 1.62 | 3.34 | 0.50
0.40 | 3.43 | 0.84 | 2.06 | 4.89 | 0.62
0.50 | 4.16 | 0.75 | 2.50 | 6.64 | 0.74
1.00 | 7.81 | 0.53 | 4.69 | 17.61 | 1.31
2.00 | 15.11 | 0.38 | 9.07 | 48.17 | 2.43
