RaphMTHN/Drone-Arduino/4 Evaluation des Performances/3 Correction maquette/Resultats Maquette/Confrontation/kd_10.csv

t (s) | roll (deg) | cons (deg) | TL (%) | TR (%)
1.12912 | 0.75 | 0.0 | 38.47 | 41.52
1.139084 | 0.7400055 | 0.0 | 40.82 | 39.17
1.1491 | 0.7400055 | 0.0 | 40.88 | 39.11
1.1591 | 0.7400055 | 0.0 | 40.89 | 39.1
1.169108 | 0.7400055 | 0.0 | 40.89 | 39.1
1.17908 | 0.7400055 | 0.0 | 40.89 | 39.1
1.189064 | 0.7400055 | 0.0 | 40.84 | 39.15
1.199076 | 0.75 | 0.0 | 40.96 | 39.03
1.209468 | 0.75 | 0.0 | 40.9 | 39.09
1.219064 | 0.75 | 0.0 | 40.97 | 39.02
1.229056 | 0.75 | 0.0 | 40.9 | 39.09
1.239032 | 0.7599945 | 0.0 | 40.97 | 39.02
1.249032 | 0.7599945 | 0.0 | 40.91 | 39.08
1.259012 | 0.7700043 | 0.0 | 40.98 | 39.01
1.26904 | 0.7700043 | 0.0 | 40.92 | 39.07
1.279 | 0.7700043 | 0.0 | 40.92 | 39.07
1.288996 | 0.7700043 | 0.0 | 40.99 | 39.0
1.298992 | 0.7799988 | 0.0 | 40.93 | 39.06
1.308992 | 0.7799988 | 0.0 | 40.93 | 39.06
1.318972 | 0.7799988 | 0.0 | 40.94 | 39.05
1.32898 | 0.7799988 | 0.0 | 40.94 | 39.05
1.338988 | 0.7700043 | 0.0 | 40.88 | 39.11
1.348968 | 0.7599945 | 0.0 | 40.87 | 39.12
1.358968 | 0.75 | 0.0 | 40.81 | 39.18
1.36896 | 0.7400055 | 0.0 | 40.81 | 39.18
1.378924 | 0.7100067 | 0.0 | 40.69 | 39.3
1.388908 | 0.6799927 | 0.0 | 40.68 | 39.31
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
