RaphMTHN/Drone-Arduino/4 Evaluation des Performances/3 Correction maquette/Resultats Maquette/Confrontation/kd_15.csv

t (s) | roll (deg) | cons (deg) | TL (%) | TR (%)
0.999236 | 1.0099945 | 0.0 | 40.94 | 39.05
1.009212 | 1.0099945 | 0.0 | 40.89 | 39.1
1.019196 | 1.0099945 | 0.0 | 40.89 | 39.1
1.0292 | 1.0099945 | 0.0 | 40.9 | 39.09
1.039188 | 1.0099945 | 0.0 | 40.9 | 39.09
1.04916 | 1.0099945 | 0.0 | 40.9 | 39.09
1.059168 | 1.0099945 | 0.0 | 40.9 | 39.09
1.06916 | 1.0 | 0.0 | 40.84 | 39.15
1.07916 | 0.9799957 | 0.0 | 40.68 | 39.31
1.089128 | 0.94999695 | 0.0 | 40.59 | 39.4
1.099132 | 0.91000366 | 0.0 | 40.44 | 39.55
1.109148 | 0.8600006 | 0.0 | 40.36 | 39.63
1.119124 | 0.80000305 | 0.0 | 40.2 | 39.79
1.129096 | 0.7100067 | 0.0 | 39.95 | 40.04
1.139092 | 0.6199951 | 0.0 | 39.77 | 40.22
1.149084 | 0.5099945 | 0.0 | 39.67 | 40.32
1.159068 | 0.3999939 | 0.0 | 39.56 | 40.43
1.169056 | 0.27000427 | 0.0 | 39.37 | 40.62
1.179044 | 0.13999939 | 0.0 | 39.24 | 40.75
1.18906 | -0.009994507 | 0.0 | 39.05 | 40.94
1.199044 | -0.1499939 | 0.0 | 39.0 | 40.99
1.209036 | -0.30000305 | 0.0 | 38.95 | 41.04
1.219024 | -0.44999695 | 0.0 | 38.89 | 41.1
1.229008 | -0.6100006 | 0.0 | 38.77 | 41.22
1.239012 | -0.7700043 | 0.0 | 38.64 | 41.35
1.249012 | -0.91999817 | 0.0 | 38.66 | 41.33
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
