RaphMTHN/Drone-Arduino/4 Evaluation des Performances/3 Correction maquette/Resultats Maquette/Confrontation/kd_20.csv

t (s) | roll (deg) | cons (deg) | TL (%) | TR (%)
1.149088 | 0.8500061 | 0.0 | 49.07 | 30.92
1.159084 | 0.8500061 | 0.0 | 40.78 | 39.21
1.169084 | 0.8500061 | 0.0 | 40.79 | 39.2
1.179072 | 0.8500061 | 0.0 | 40.79 | 39.2
1.189088 | 0.8500061 | 0.0 | 40.8 | 39.19
1.19904 | 0.8500061 | 0.0 | 40.8 | 39.19
1.209032 | 0.8500061 | 0.0 | 40.8 | 39.19
1.219016 | 0.8500061 | 0.0 | 40.81 | 39.18
1.229028 | 0.83999634 | 0.0 | 40.72 | 39.27
1.239008 | 0.8200073 | 0.0 | 40.54 | 39.45
1.249 | 0.7899933 | 0.0 | 40.43 | 39.56
1.258984 | 0.7400055 | 0.0 | 40.16 | 39.83
1.268984 | 0.6799927 | 0.0 | 40.08 | 39.91
1.278976 | 0.6199951 | 0.0 | 39.95 | 40.04
1.28898 | 0.55000305 | 0.0 | 39.85 | 40.14
1.298964 | 0.47000122 | 0.0 | 39.64 | 40.35
1.308976 | 0.38000488 | 0.0 | 39.52 | 40.47
1.318944 | 0.27000427 | 0.0 | 39.3 | 40.69
1.328932 | 0.16000366 | 0.0 | 39.18 | 40.81
1.33894 | 0.02999878 | 0.0 | 38.95 | 41.04
1.348932 | -0.08999634 | 0.0 | 38.9 | 41.09
1.358904 | -0.22999573 | 0.0 | 38.66 | 41.33
1.368888 | -0.3600006 | 0.0 | 38.78 | 41.21
1.378888 | -0.5 | 0.0 | 38.55 | 41.44
1.388896 | -0.6399994 | 0.0 | 38.4 | 41.59
1.398868 | -0.7899933 | 0.0 | 38.42 | 41.57
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
