RaphMTHN/Drone-Arduino/4 Evaluation des Performances/3 Correction maquette/Resultats Maquette/Confrontation/kd_25.csv

t (s) | roll (deg) | cons (deg) | TL (%) | TR (%)
1.288996 | 0.6399994 | 0.0 | 66.49 | 13.5
1.298976 | 0.6399994 | 0.0 | 41.11 | 38.88
1.30898 | 0.6399994 | 0.0 | 41.12 | 38.87
1.318956 | 0.6399994 | 0.0 | 41.13 | 38.86
1.328952 | 0.6399994 | 0.0 | 41.14 | 38.85
1.338964 | 0.6399994 | 0.0 | 41.14 | 38.85
1.348924 | 0.6399994 | 0.0 | 41.13 | 38.86
1.358948 | 0.6399994 | 0.0 | 41.13 | 38.86
1.368928 | 0.6300049 | 0.0 | 41.01 | 38.98
1.3789 | 0.6100006 | 0.0 | 40.81 | 39.18
1.388912 | 0.5700073 | 0.0 | 40.61 | 39.38
1.398896 | 0.5200043 | 0.0 | 40.4 | 39.59
1.4089 | 0.4600067 | 0.0 | 40.27 | 39.72
1.418892 | 0.3999939 | 0.0 | 40.14 | 39.85
1.428872 | 0.32000732 | 0.0 | 39.9 | 40.09
1.438864 | 0.22999573 | 0.0 | 39.56 | 40.43
1.448856 | 0.13000488 | 0.0 | 39.51 | 40.48
1.458852 | 0.020004272 | 0.0 | 39.26 | 40.73
1.468848 | -0.08999634 | 0.0 | 39.2 | 40.79
1.47882 | -0.22000122 | 0.0 | 38.93 | 41.06
1.488836 | -0.3600006 | 0.0 | 38.67 | 41.32
1.498808 | -0.5 | 0.0 | 38.59 | 41.4
1.508796 | -0.6300049 | 0.0 | 38.64 | 41.35
1.518804 | -0.7799988 | 0.0 | 38.35 | 41.64
1.528784 | -0.9299927 | 0.0 | 38.16 | 41.83
1.538768 | -1.0800018 | 0.0 | 38.17 | 41.82
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
