RaphMTHN/Drone-Arduino/4 Evaluation des Performances/3 Correction maquette/Resultats Maquette/Confrontation/kd_30.csv

t (s) | roll (deg) | cons (deg) | TL (%) | TR (%)
0.8893 | 0.6399994 | 0.0 | 54.04 | 25.95
0.899288 | 0.6399994 | 0.0 | 40.18 | 39.81
0.909288 | 0.6399994 | 0.0 | 40.19 | 39.8
0.919292 | 0.6399994 | 0.0 | 40.2 | 39.79
0.929292 | 0.6399994 | 0.0 | 40.21 | 39.78
0.93928 | 0.6399994 | 0.0 | 40.21 | 39.78
0.949248 | 0.6399994 | 0.0 | 40.21 | 39.78
0.959244 | 0.6399994 | 0.0 | 40.23 | 39.76
0.969232 | 0.6300049 | 0.0 | 40.11 | 39.88
0.979216 | 0.6300049 | 0.0 | 40.23 | 39.76
0.989212 | 0.6199951 | 0.0 | 40.12 | 39.87
0.999196 | 0.6199951 | 0.0 | 40.13 | 39.86
1.009196 | 0.6100006 | 0.0 | 40.13 | 39.86
1.019176 | 0.6000061 | 0.0 | 40.01 | 39.98
1.0292 | 0.58000183 | 0.0 | 40.01 | 39.98
1.03918 | 0.5700073 | 0.0 | 40.01 | 39.98
1.049148 | 0.55000305 | 0.0 | 40.0 | 39.99
1.059152 | 0.5299988 | 0.0 | 39.88 | 40.11
1.06916 | 0.5200043 | 0.0 | 40.0 | 39.99
1.07914 | 0.5 | 0.0 | 39.88 | 40.11
1.089156 | 0.47999573 | 0.0 | 39.87 | 40.12
1.099132 | 0.4600067 | 0.0 | 39.85 | 40.14
1.109128 | 0.42999268 | 0.0 | 39.73 | 40.26
1.119124 | 0.3999939 | 0.0 | 39.73 | 40.26
1.12912 | 0.36999512 | 0.0 | 39.73 | 40.26
1.139108 | 0.33999634 | 0.0 | 39.7 | 40.29
1.149092 | 0.30999756 | 0.0 | 39.58 | 40.41
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
