RaphMTHN/Drone-Arduino/4 Evaluation des Performances/3 Correction maquette/Resultats Maquette/Performances/11-6--19-28[0.97,1.4,0.32].csv

t (s) | roll (deg) | cons (deg) | TL (%) | TR (%)
1.698688 | 0.33000183 | 0.0 | 51.8 | 28.19
1.70868 | 0.33999634 | 0.0 | 40.77 | 39.22
1.718672 | 0.33000183 | 0.0 | 40.71 | 39.28
1.72866 | 0.33999634 | 0.0 | 40.8 | 39.19
1.73866 | 0.33999634 | 0.0 | 40.71 | 39.28
1.748652 | 0.33999634 | 0.0 | 40.79 | 39.2
1.758656 | 0.33000183 | 0.0 | 40.66 | 39.33
1.768648 | 0.33000183 | 0.0 | 40.72 | 39.27
1.778624 | 0.33999634 | 0.0 | 40.87 | 39.12
1.78862 | 0.3500061 | 0.0 | 40.89 | 39.1
1.798604 | 0.38000488 | 0.0 | 41.03 | 38.96
1.808596 | 0.41000366 | 0.0 | 41.12 | 38.87
1.818592 | 0.44000244 | 0.0 | 41.13 | 38.86
1.8286 | 0.47999573 | 0.0 | 41.24 | 38.75
1.83858 | 0.5299988 | 0.0 | 41.32 | 38.67
1.84856 | 0.58999634 | 0.0 | 41.5 | 38.49
1.858556 | 0.6499939 | 0.0 | 41.43 | 38.56
1.868552 | 0.7200012 | 0.0 | 41.67 | 38.32
1.878568 | 0.7899933 | 0.0 | 41.64 | 38.35
1.888536 | 0.8600006 | 0.0 | 41.68 | 38.31
1.898548 | 0.91999817 | 0.0 | 41.68 | 38.31
1.908536 | 0.9900055 | 0.0 | 41.72 | 38.27
1.918524 | 1.0599976 | 0.0 | 41.75 | 38.24
1.928512 | 1.1199951 | 0.0 | 41.71 | 38.28
1.938504 | 1.1900024 | 0.0 | 41.81 | 38.18
1.9485 | 1.2400055 | 0.0 | 41.62 | 38.37
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
