RaphMTHN/Drone-Arduino/4 Evaluation des Performances/2 Correction Modele Saturation/Ziegler Nichols/loi empirique/reponse_kd_050.png

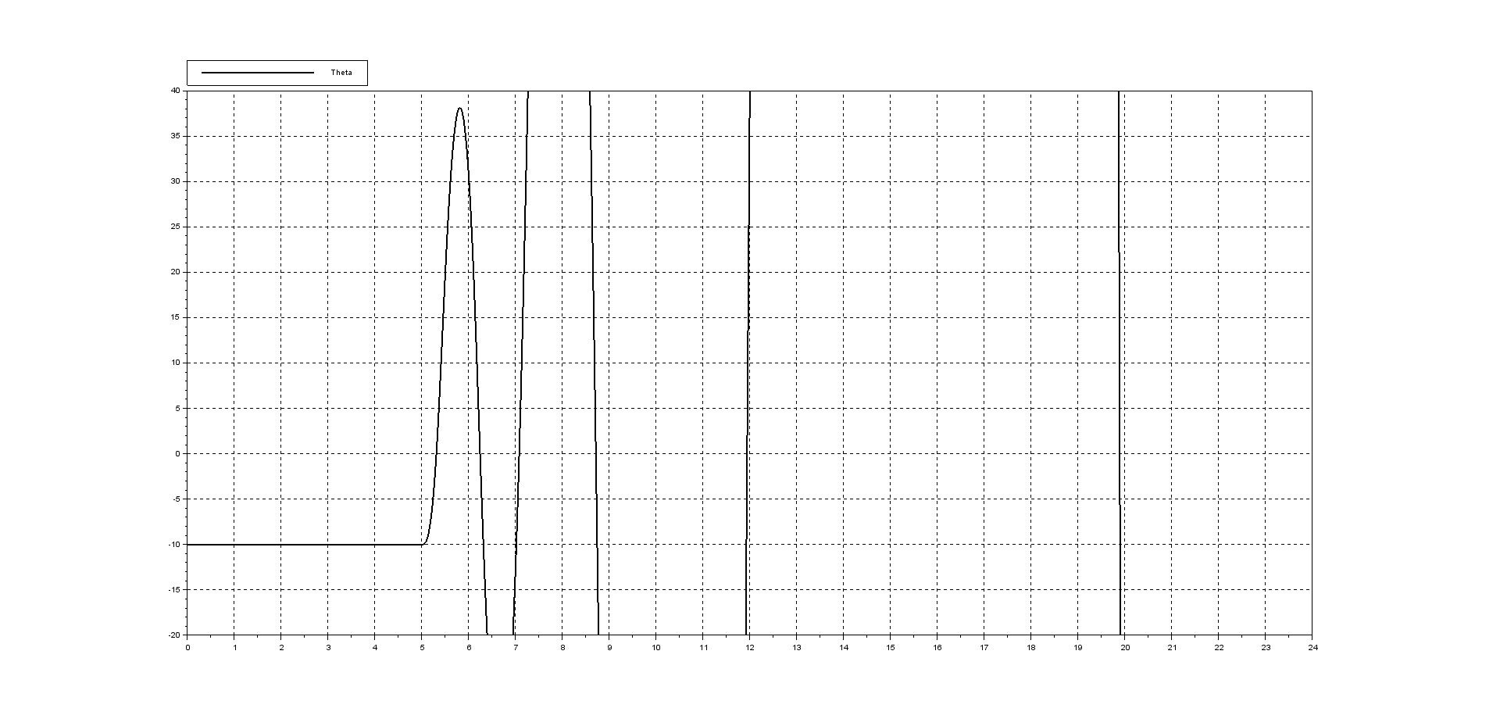
4 Evaluation des Performances/2 Correction Modele Saturation/Ziegler Nichols/loi empirique/reponse_kd_050.png
