RaphMTHN/Drone-Arduino/4 Evaluation des Performances/3 Correction maquette/Resultats Modelisation/Confrontation Modele Maquette/png/theo_exp_Kd_030.png

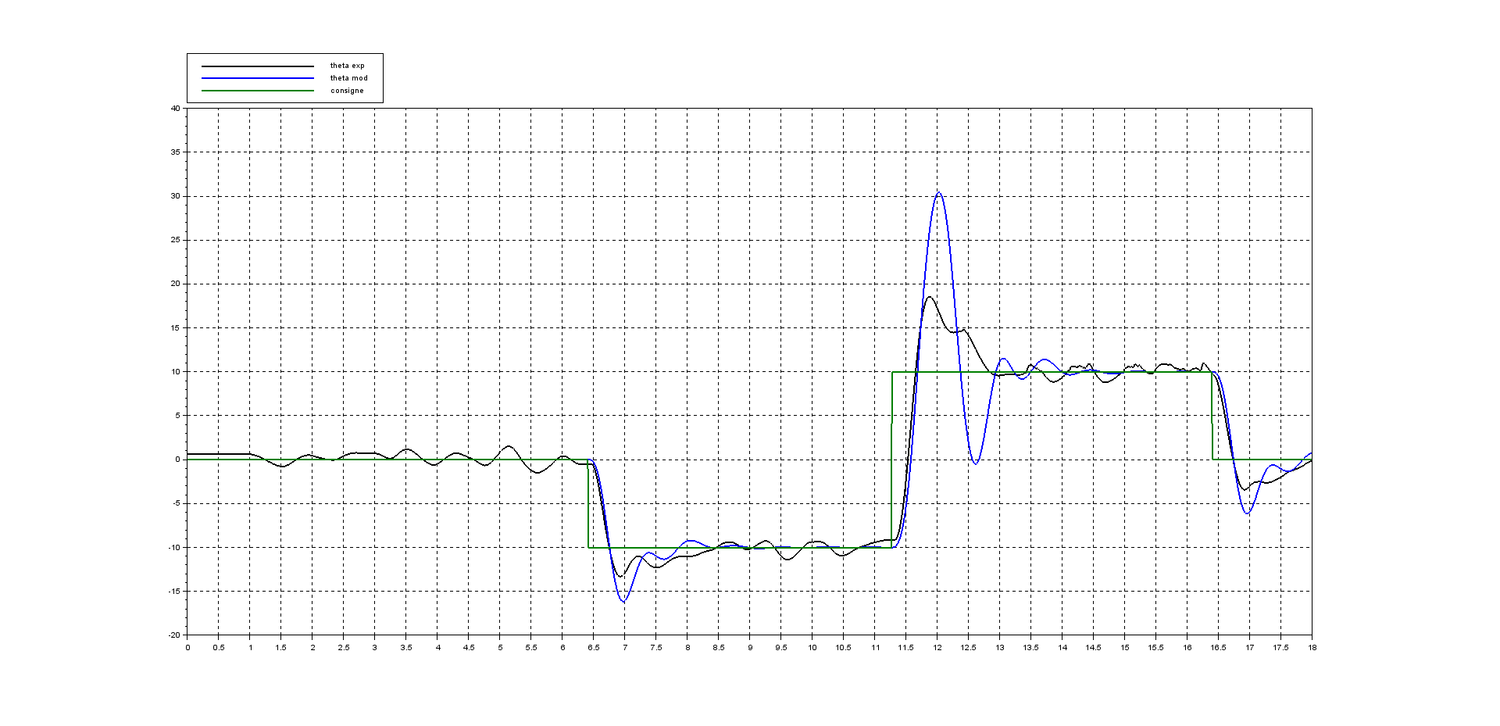
4 Evaluation des Performances/3 Correction maquette/Resultats Modelisation/Confrontation Modele Maquette/png/theo_exp_Kd_030.png
