RaphMTHN/Drone-Arduino/4 Evaluation des Performances/3 Correction maquette/Resultats Modelisation/Performances Modele Maquette/png/reponse_indicielle_exp.png

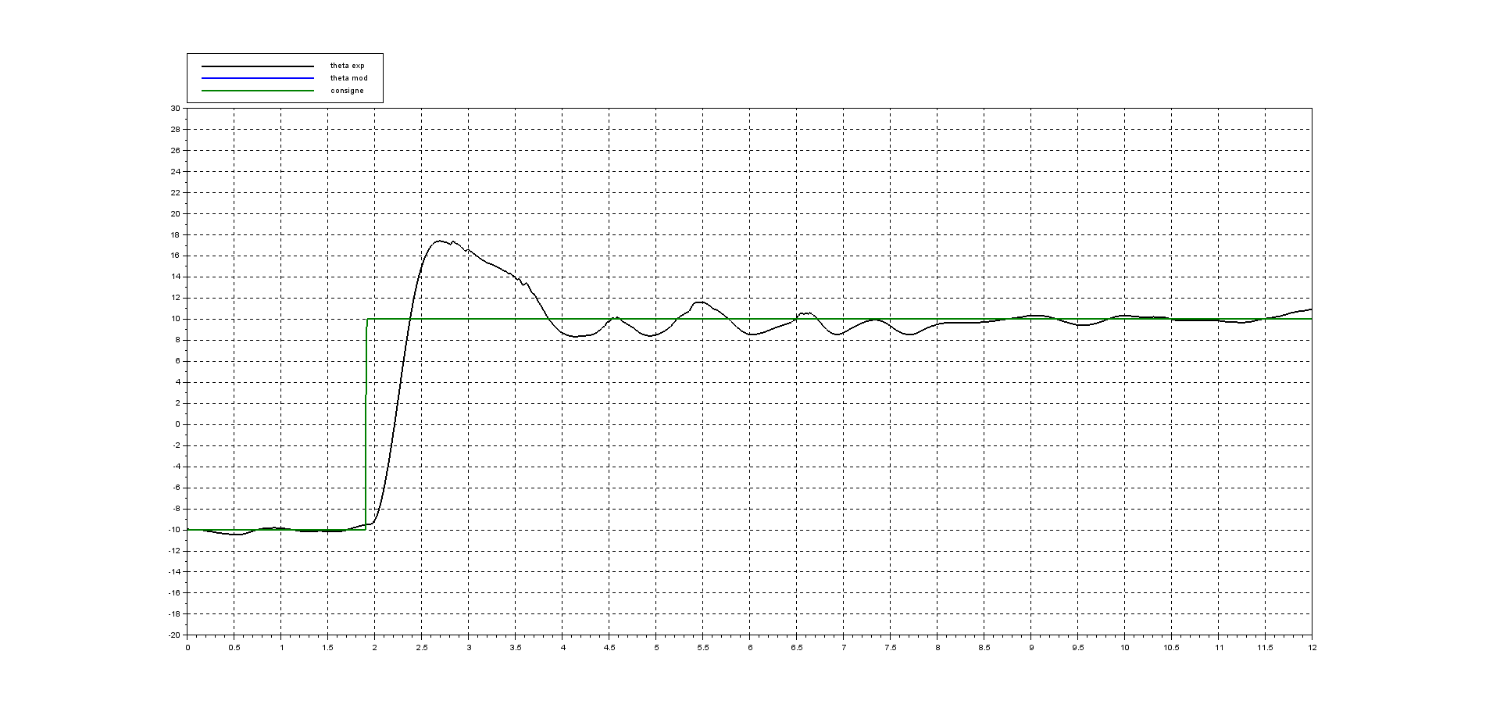
4 Evaluation des Performances/3 Correction maquette/Resultats Modelisation/Performances Modele Maquette/png/reponse_indicielle_exp.png
