RaphMTHN/Drone-Arduino/1 Analyse Fonctionnelle/4 Restriction du Probleme/schema cinematique annote.png

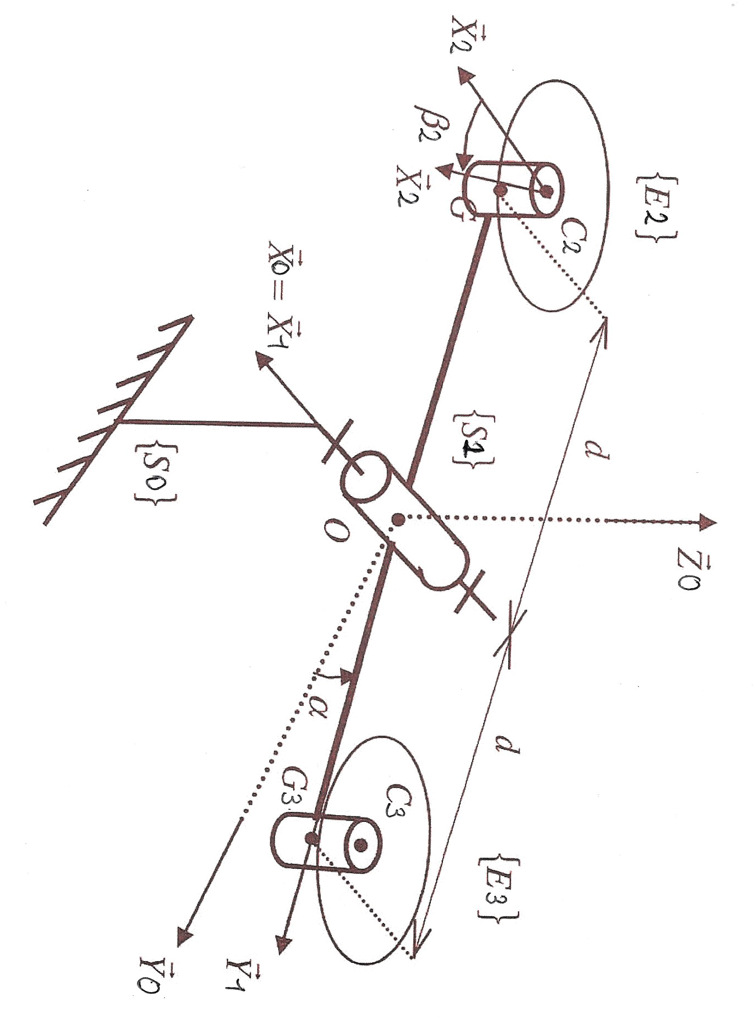
1 Analyse Fonctionnelle/4 Restriction du Probleme/schema cinematique annote.png
