RaphMTHN/Drone-Arduino/1 Analyse Fonctionnelle/4 Restriction du Probleme/Schéma cinématique TD.jpg

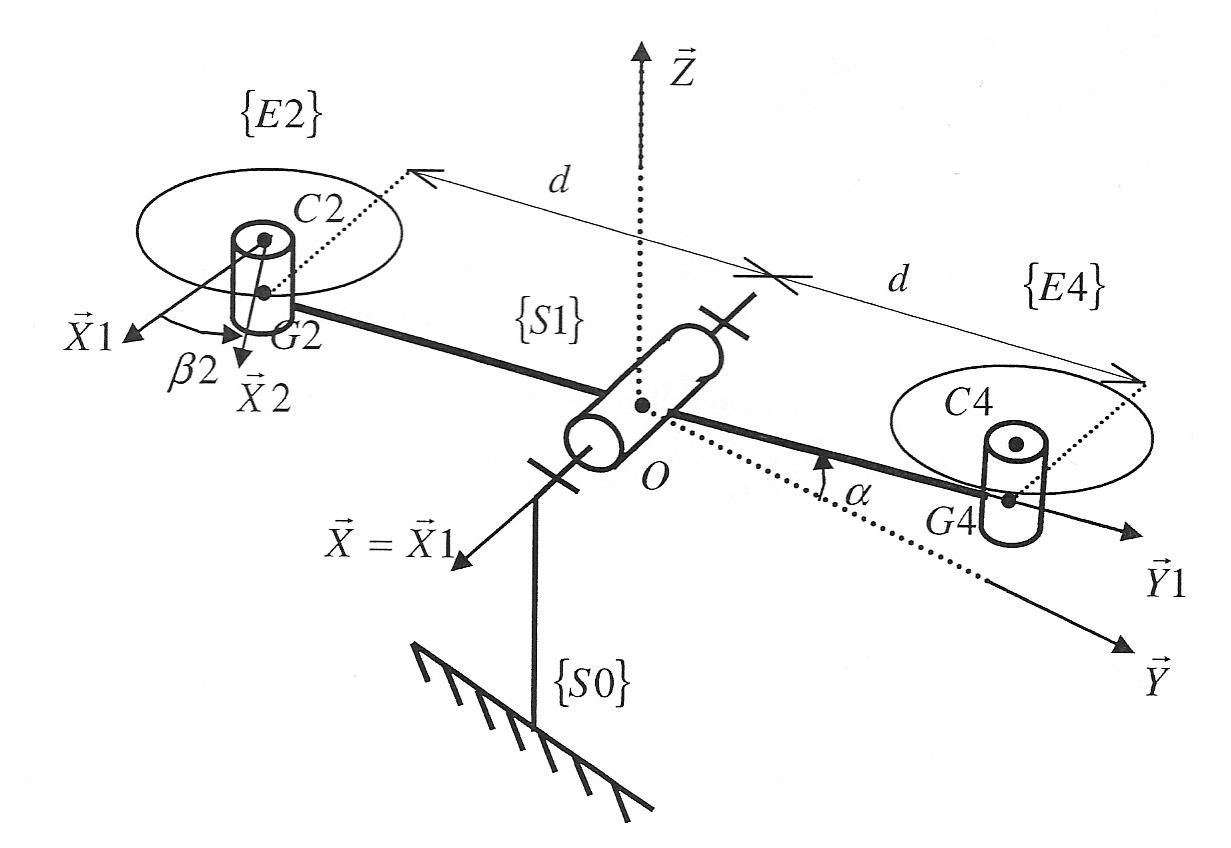
1 Analyse Fonctionnelle/4 Restriction du Probleme/Schéma cinématique TD.jpg
