RaphMTHN/Drone-Arduino/4 Evaluation des Performances/3 Correction maquette/Resultats Modelisation/Confrontation Modele Maquette/pdf/theo_exp_Kd_010.pdf

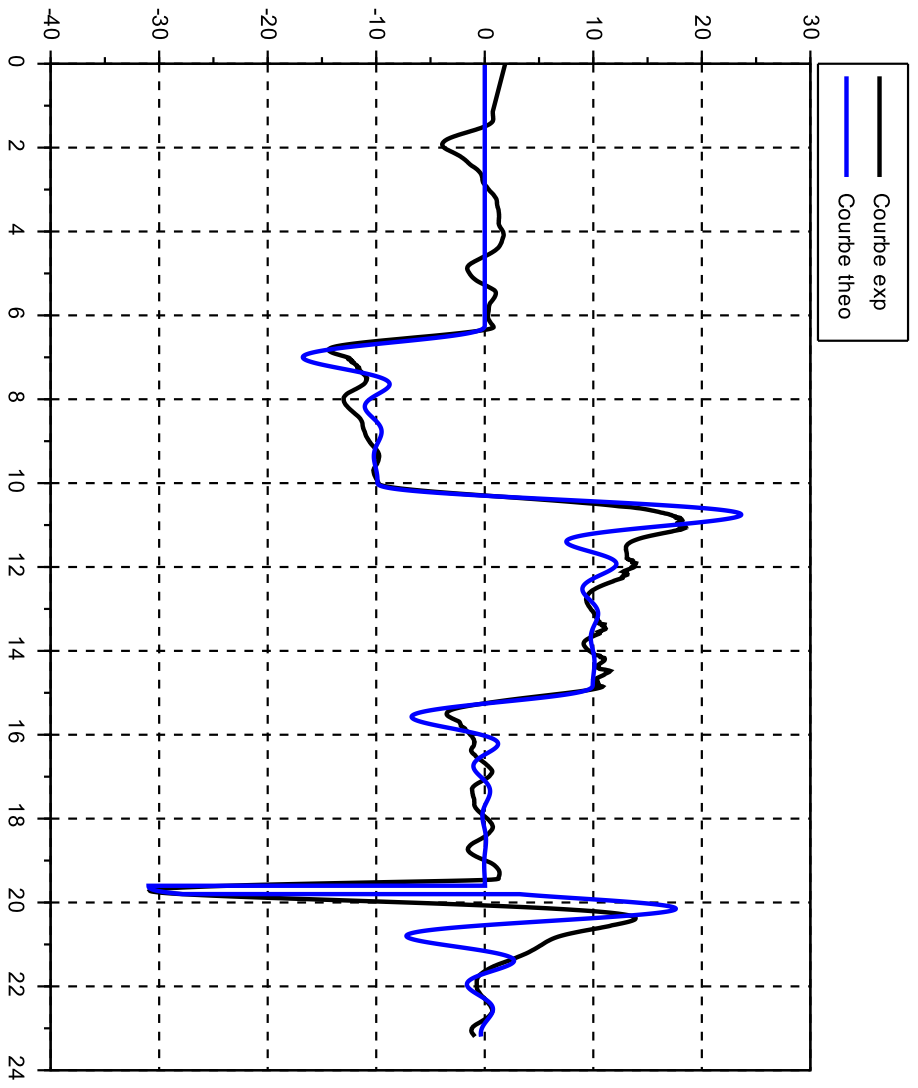
[picture p110: page 1]
