RaphMTHN/Drone-Arduino/4 Evaluation des Performances/3 Correction maquette/Resultats Modelisation/Confrontation Modele Maquette/pdf/theo_exp_Kd_015_exp.pdf

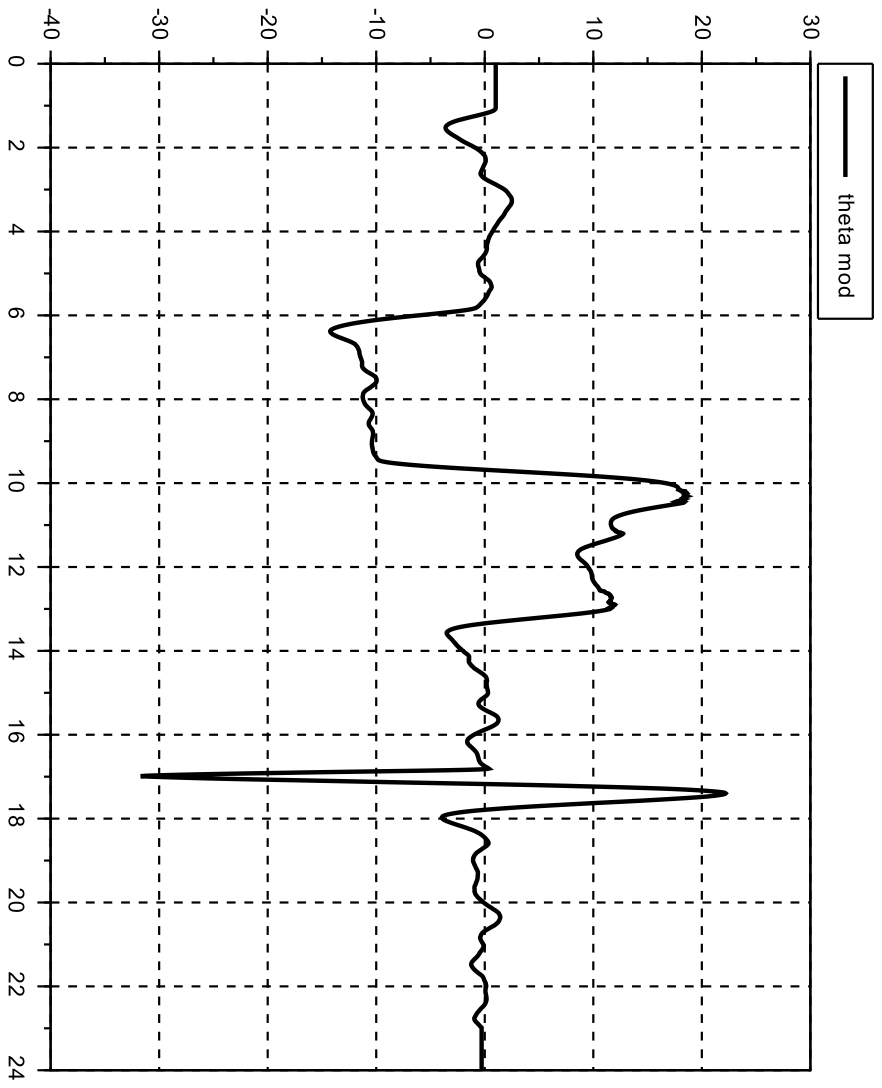
[picture p112: page 1]
