RaphMTHN/Drone-Arduino/4 Evaluation des Performances/3 Correction maquette/Resultats Modelisation/Confrontation Modele Maquette/pdf/theo_exp_Kd_015_tout.pdf

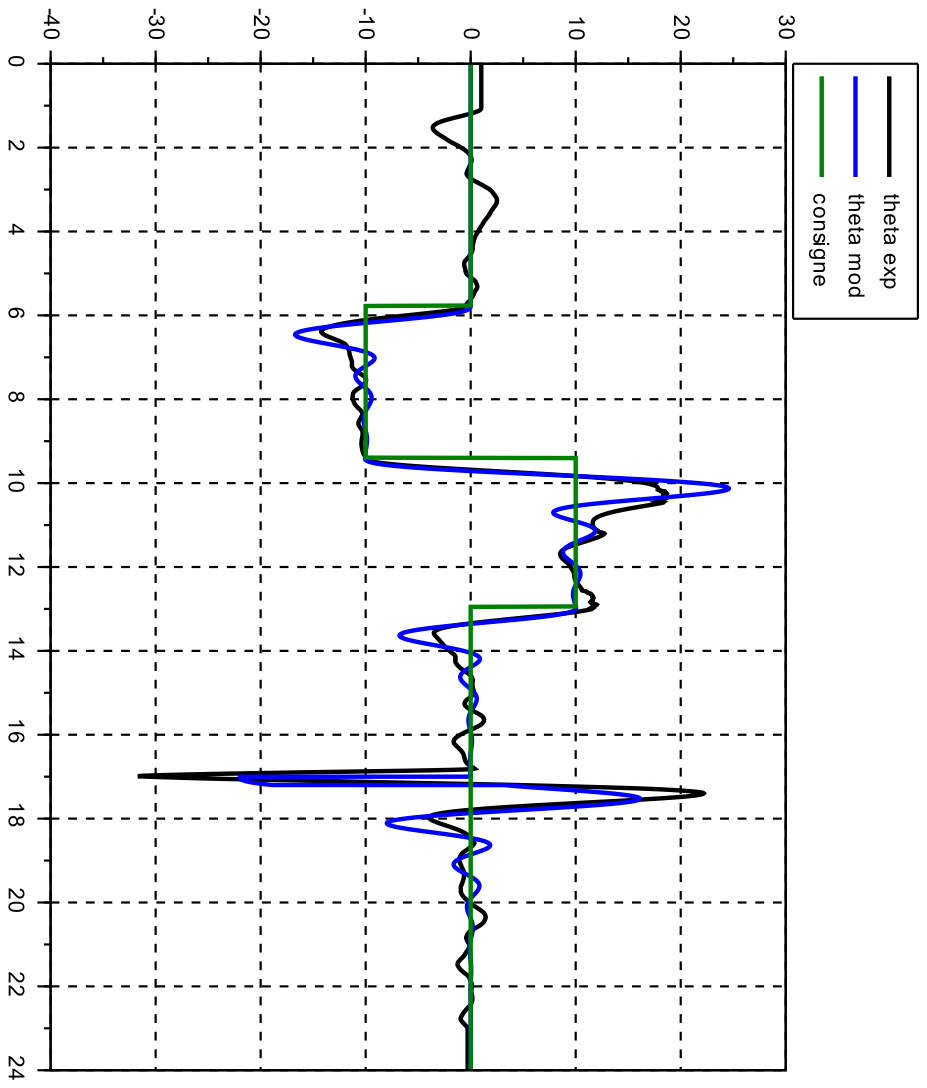
[picture p114: page 1]
