RaphMTHN/Drone-Arduino/4 Evaluation des Performances/3 Correction maquette/Resultats Modelisation/Performances Modele Maquette/pdf/reponse_indicielle_cons_mod.pdf

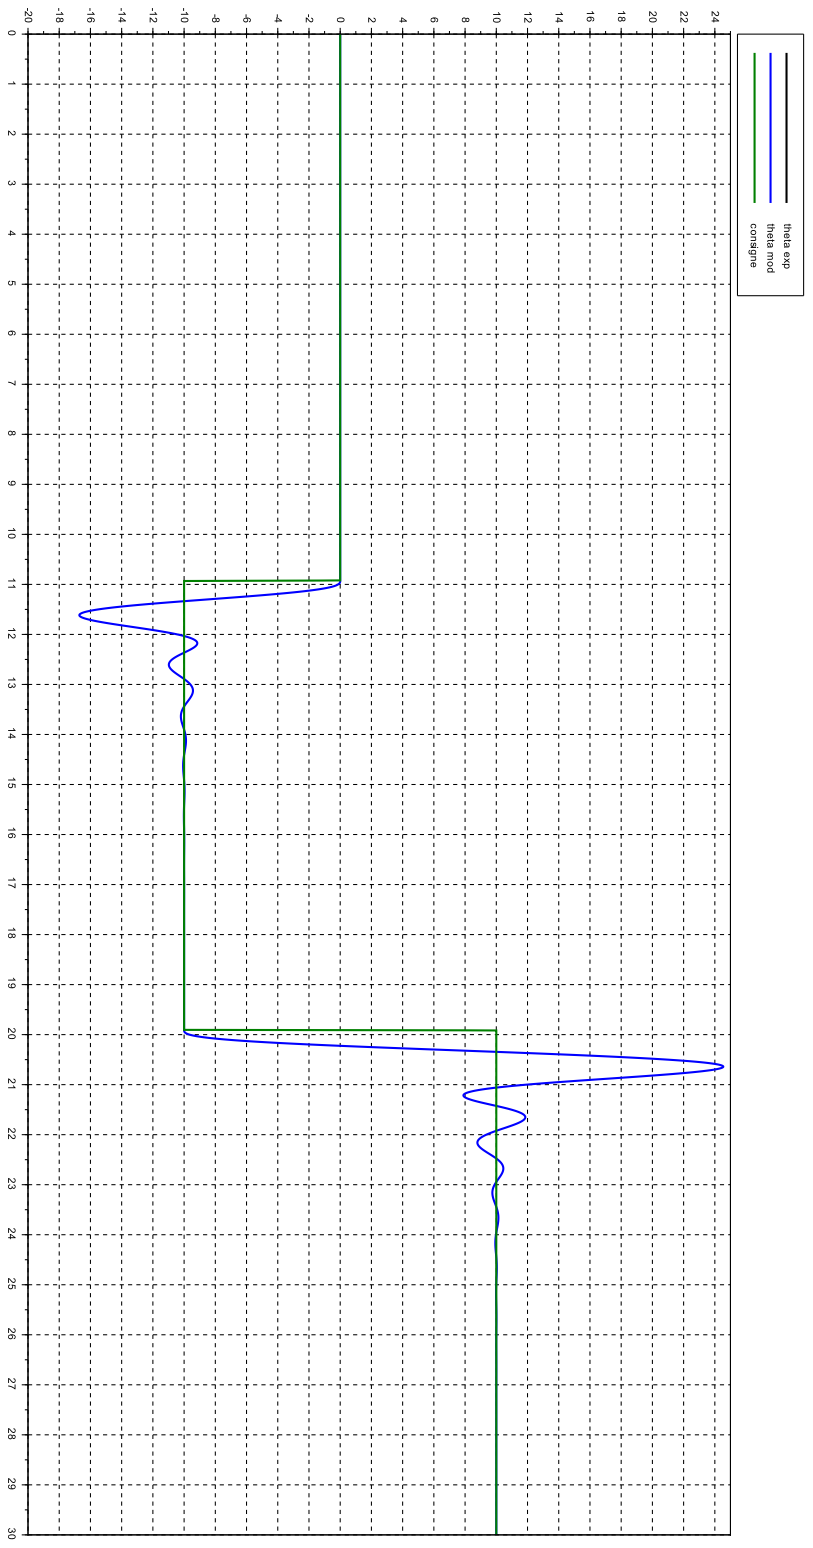
[picture p120: page 1]
