RaphMTHN/Drone-Arduino/4 Evaluation des Performances/3 Correction maquette/Resultats Modelisation/Performances Modele Maquette/pdf/reponse_indicielle_exp.pdf

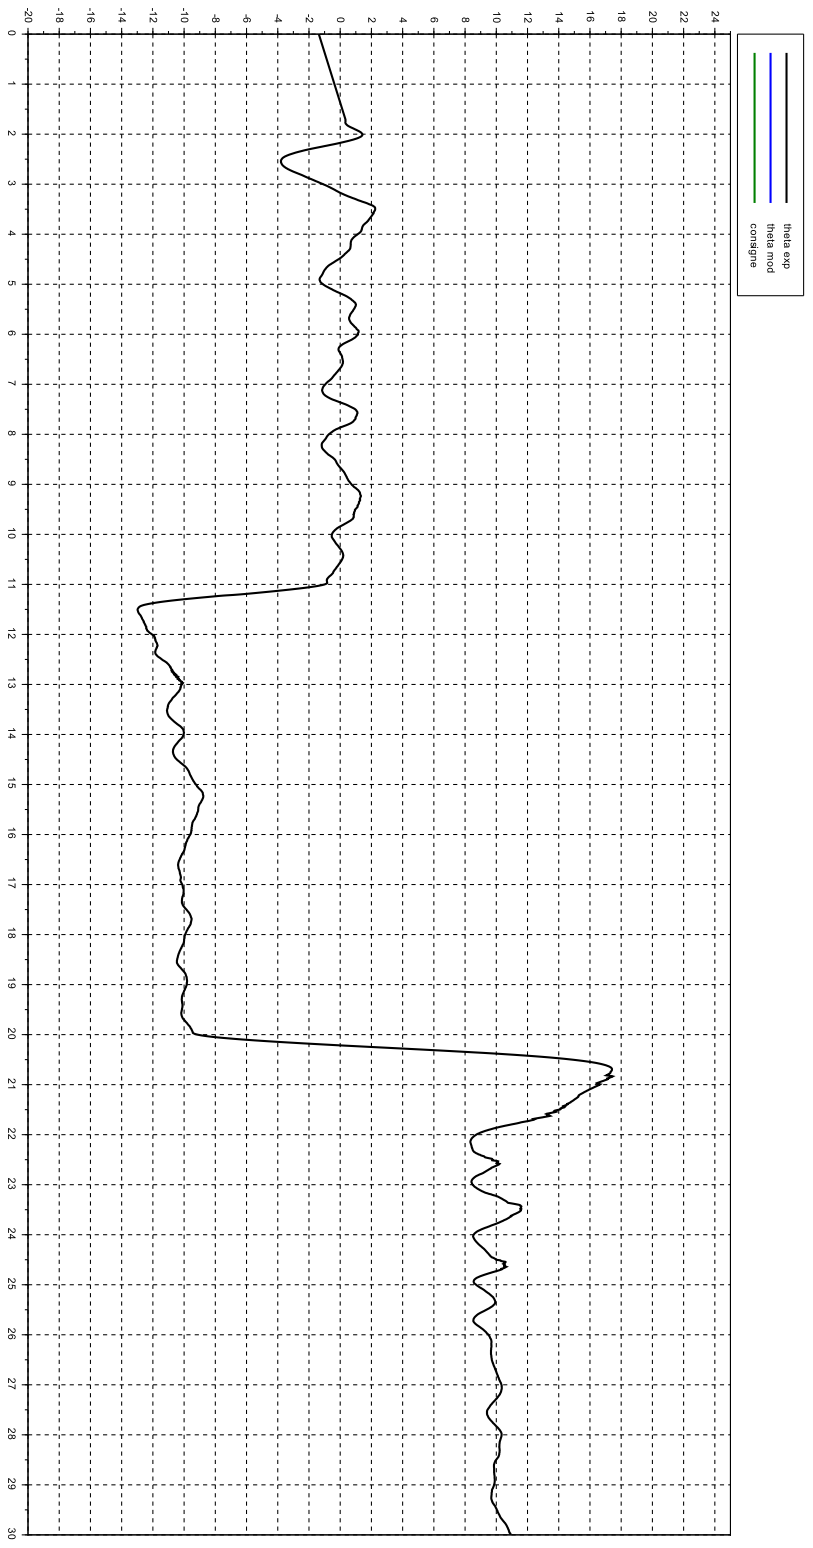
[picture p121: page 1]
