RaphMTHN/Drone-Arduino/(commit log)

2017-05-29 Ajoute le .md decrivant l'utilisation du protocole serie pour la communication entre le programme embarque et le programme d'interface graphique
2017-05-29 Ajoute le dossier Gyroscope contenant pour l'instant deux fichiers .md decrivant l'utilisation du gyroscope dans le programme embarque, et le protocole de mesure de la frequence d'echantillonnage eff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
2017-05-29 Update du fichier frequence_sample_gyro.md : meilleure description de la premiere experience
2017-05-29 Ajoute le code cpp des differentes bibliothèques utilisees par l'objet personnel Gyro. /n Ajout d'une methode getMeasureTime() permettant de recuperer l'instant d'acquisition des données capteur. /n 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
2017-05-29 Update du dossier mesure gyro en ajoutant les fichiers excel enregistres en csv, et en text with fixed width
2017-05-29 Rectification : oubli d'integrer les fichiers au commit precedent
    [resultats mesure temps echantillonnage.csv]
2017-05-29 Ajout de la deuxieme mesure de la frequence d'echantillonnage du DMP, amelioration de l'affichage de l'exp1
    [donnees brutes.csv, occurences periode sample csv.csv, occurences periode sample.xlsx]
2017-05-29 Amelioration des tableaux de donnees de l'exp2
    [occurences periode sample csv.csv]
2017-05-29 Retire le protocole experimental de mesure du baudrate du protocole serie entre arduino et processing, juge pour l'instant comme annexe, plus autres petites modifs du .md
2017-05-29 Ajout des dossiers Core (programme arduino embarque), GUI (interface graphique Processing, ET bibliotheques utilisees), Moteurs ESC. Deux README.md pour Core et GUI
2017-05-29 Modification du fichier d'enregistrement des donnees par Processing, en un fichier .csv separe par des semicolons ;
2017-05-29 Ajoute documentation invensense a propos du mpu5060 et de la representation algebrique de la position d'un repere en rotation libre
2017-06-05 Ajout du rapport latex du TIPE, contenant la modelisation des helices, moteurs et le calcul dynamique
2017-06-06 Ajout de l'expérience timer pwm, formattage markdown
    [Résultats PWM (21-06-2016).xlsx, pwm_timer1.csv, pwm_timer2.csv]
2017-06-06 Ajout de documents pdf relatifs aux timers arduino et aux moteurs brushless
2017-06-09 Ajout des etapes de modelisation des composants a partir de donnees constructeur (moteur , helice)
    [Modelisation Helice.xlsx, Profil Naca 2412 polaires.xlsx, tmotor_air_2213_data.csv, xf-naca2412-10^6 without metadata.csv, xf-naca2412-il-1000000.csv]
2017-06-10 Ajout des étapes de simulation causale, tous les parametres etant connus
2017-06-10 Ajout de l'etape d'ajustement de la modelisation theorique a la maquette, a l'aide des conditions d'oscillations en regime juste instable (Routh). Deboguage du code core et de la bibliotheque gyro
    [10-6[1.2,0.0,0.1].csv, 10-6[1.25,0.0,0.1].csv, 10-6[1.27,0.0,0.1].csv, 10-6[1.28,0.0,0.1].csv, 10-6[1.29,0.0,0.1].csv, 10-6[1.3,0.0,0.1].csv, Profil Naca 2412 polaires.xlsx, synthese_reponses_temporelles_routh.xlsx]
2017-06-10 Ajout du textField, de la variable, des bytes correspondants a l'utilisation d'une consigne en echelon reglable depuis l'etat de veille et de marche
2017-06-10 Optimisation de l'enregistrement csv pour faciliter le trace de courbes sur excel
2017-06-11 Ajout massif de travail sur la modelisation et sur la maquette
    [10-6[1.2,0.0,0.1].csv, 10-6[1.25,0.0,0.1].csv, 10-6[1.27,0.0,0.1].csv, 10-6[1.28,0.0,0.1].csv, 10-6[1.29,0.0,0.1].csv, 10-6[1.3,0.0,0.1].csv, 11-6--15-15[0.83,0.0,0.05].csv, 11-6--15-15[1.28,0.0,0.1].csv]
2017-06-12 restructuration du projet, ajout de contenu
    [10-6[1.2,0.0,0.1].csv, 10-6[1.25,0.0,0.1].csv, 10-6[1.27,0.0,0.1].csv, 10-6[1.28,0.0,0.1].csv, 10-6[1.29,0.0,0.1].csv, 10-6[1.3,0.0,0.1].csv, 11-6--15-15[0.83,0.0,0.05].csv, 11-6--15-15[1.28,0.0,0.1].csv]
2017-06-25 Structuration du projet, ajout du rapport et de la présentation
    [11-6--15-15[0.83,0.0,0.05].csv, 11-6--15-15[1.28,0.0,0.1].csv, 11-6--15-16[1.28,0.0,0.1].csv, 11-6--15-16[1.65,0.0,0.15].csv, 11-6--15-16[2.0,0.0,0.2].csv, 11-6--15-17[2.3,0.0,0.25].csv, 11-6--19-28[0.97,1.4,0.32].csv, 11-6--19-30[0.97,1.4,0.32].csv]
2017-06-25 Ajout des vidéos sur YT, liens dans le dossier Vidéos
2017-06-25 Correction des liens youtube
